shadohead/launchlab/THIRD_PARTY_NOTICES.md

# Attribution

- BP Gear Port Connector: Migbello, [Thingiverse 6856080](https://www.thingiverse.com/thing:6856080), Creative Commons Attribution Share Alike; version unspecified in the supplied notice. LaunchLab modifications include the adapter, latch bridge, optical cradle, pressure plate and M5 mount. Preserved notices accompany the hardware. No endorsement is implied.
- [VQF](https://github.com/dlaidig/vqf), Daniel Laidig and Thomas Seel: MIT; vendored commit `86ba56bdd3158b9b05f9f9fe5596866ba326438c` with copyright headers and license intact.
- Bosch BMI270 Sensor API: **BSD-3-Clause**, vendored via SparkFun_BMI270_Arduino_Library commit `21ea234de321da07c552f7a43cb36f7df4f73a27`. Copyright, conditions and disclaimer are retained in `firmware/LaunchLabMini/src/bmi270/LICENSE` and each frozen source release.
- [M5Unified](https://github.com/m5stack/M5Unified) 0.2.23 and [M5GFX](https://github.com/m5stack/M5GFX) 0.2.30: retain upstream MIT licenses when downloaded by the build.
- [Arduino ESP32](https://github.com/espressif/arduino-esp32) 3.3.0: upstream LGPL-2.1 and component licenses apply. Toolchain sources are obtained by the build script; compiled firmware includes these components.
- [esptool-js](https://github.com/espressif/esptool-js) 0.7.0: Apache-2.0; dependency of the retired GitHub Pages updater.
- [spark-md5](https://github.com/satazor/js-spark-md5) 3.0.2: MIT; dependency of the retired GitHub Pages updater.

The retired GitHub Pages interface used DM Sans and Space Grotesk from Google Fonts under the SIL Open Font License. The compatibility page now contains only an HTML redirect and static artifacts. The maintained updater and its dependencies live in [Beywatch](https://github.com/shadohead/beywatch).

## Bosch BMI270 binary distribution notice

Copyright (c) 2023 Bosch Sensortec GmbH. All rights reserved.

BSD-3-Clause

Redistribution and use in source and binary forms, with or without
modification, are permitted provided that the following conditions are met:

1. Redistributions of source code must retain the above copyright
    notice, this list of conditions and the following disclaimer.

2. Redistributions in binary form must reproduce the above copyright
    notice, this list of conditions and the following disclaimer in the
    documentation and/or other materials provided with the distribution.

3. Neither the name of the copyright holder nor the names of its
    contributors may be used to endorse or promote products derived from
    this software without specific prior written permission.

THIS SOFTWARE IS PROVIDED BY THE COPYRIGHT HOLDERS AND CONTRIBUTORS
"AS IS" AND ANY EXPRESS OR IMPLIED WARRANTIES, INCLUDING, BUT NOT
LIMITED TO, THE IMPLIED WARRANTIES OF MERCHANTABILITY AND FITNESS
FOR A PARTICULAR PURPOSE ARE DISCLAIMED. IN NO EVENT SHALL THE
COPYRIGHT HOLDER OR CONTRIBUTORS BE LIABLE FOR ANY DIRECT, INDIRECT,
INCIDENTAL, SPECIAL, EXEMPLARY, OR CONSEQUENTIAL DAMAGES
(INCLUDING, BUT NOT LIMITED TO, PROCUREMENT OF SUBSTITUTE GOODS OR
SERVICES; LOSS OF USE, DATA, OR PROFITS; OR BUSINESS INTERRUPTION)
HOWEVER CAUSED AND ON ANY THEORY OF LIABILITY, WHETHER IN CONTRACT,
STRICT LIABILITY, OR TORT (INCLUDING NEGLIGENCE OR OTHERWISE) ARISING
IN ANY WAY OUT OF THE USE OF THIS SOFTWARE, EVEN IF ADVISED OF THE
POSSIBILITY OF SUCH DAMAGE.
