shadohead/launchlab/site/public/hardware/downloads/top-dock-v098.3mf

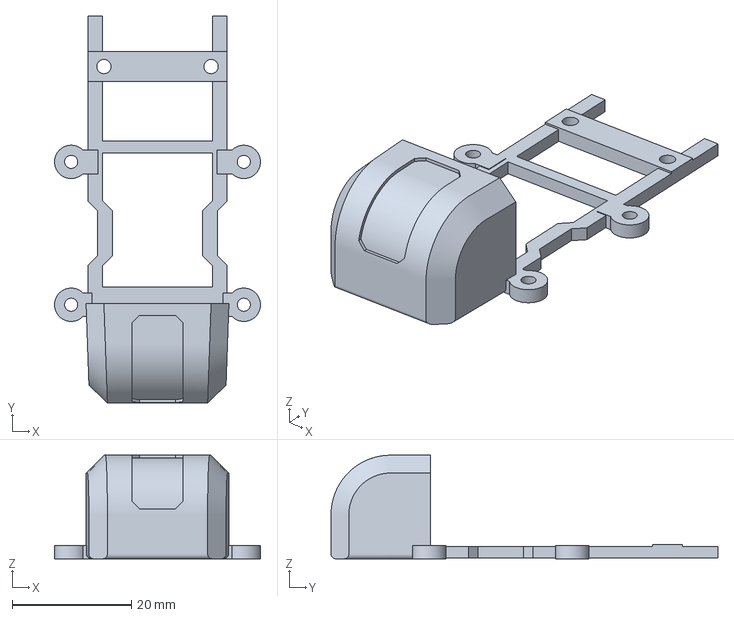
[picture p1: CAD file, 2026-10-12]
site/public/hardware/downloads/top-dock-v098.3mf
34.6 x 65.0 x 17.4 mm
