shadohead/launchlab/site/public/hardware/downloads/compact-base-v102.3mf

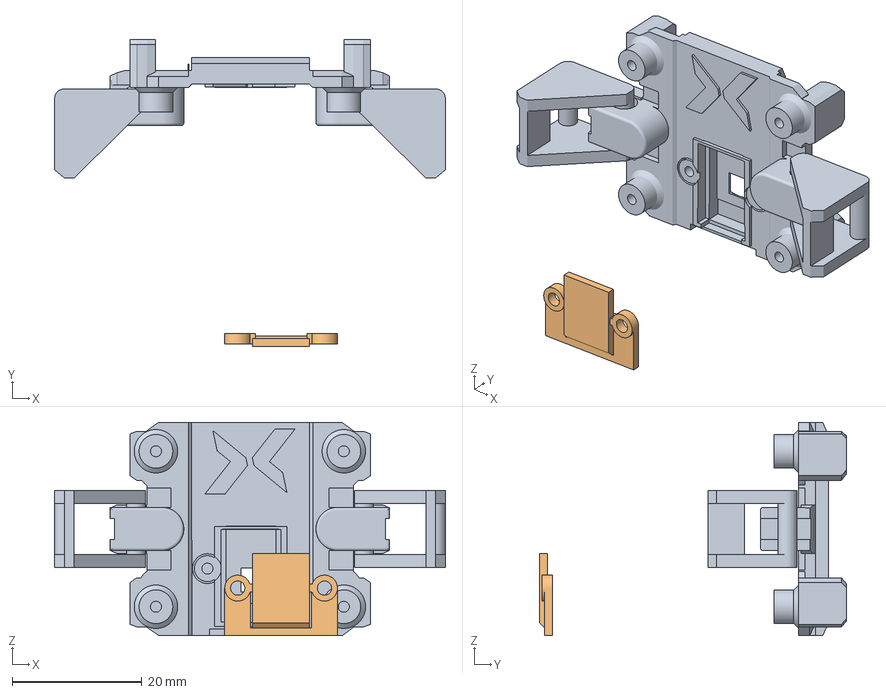
[picture p2: CAD file, 2026-10-12]
site/public/hardware/downloads/compact-base-v102.3mf
60.4 x 47.4 x 33.0 mm
01_QRE_OPEN_PRINT_IN_PLACE
03_QRE_pressure_bar
