shadohead/launchlab/site/public/hardware/downloads/m5-carrier-v097.3mf

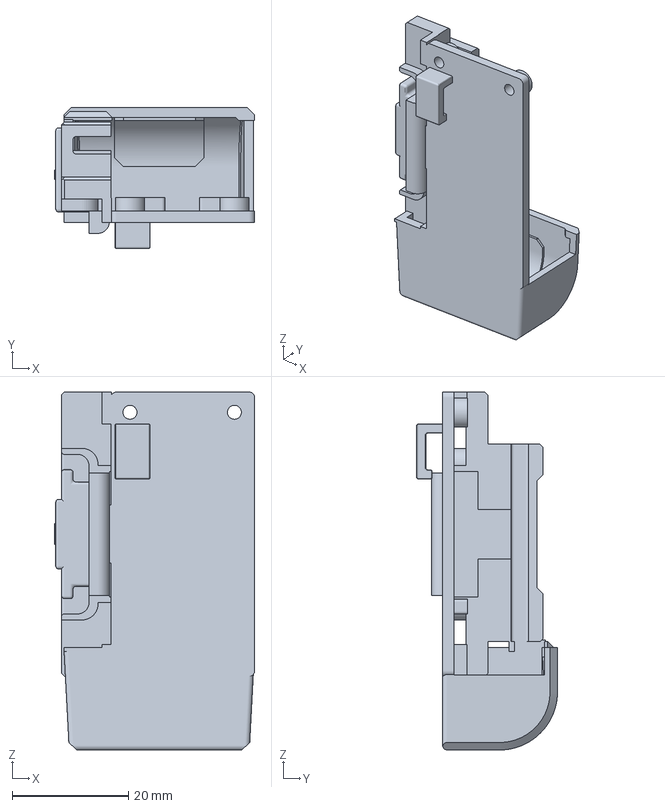
[picture p3: CAD file, 2026-10-12]
site/public/hardware/downloads/m5-carrier-v097.3mf
34.5 x 24.3 x 61.7 mm
