shadohead/launchlab/site/public/hardware/downloads/standard-hinge-test-v069.3mf

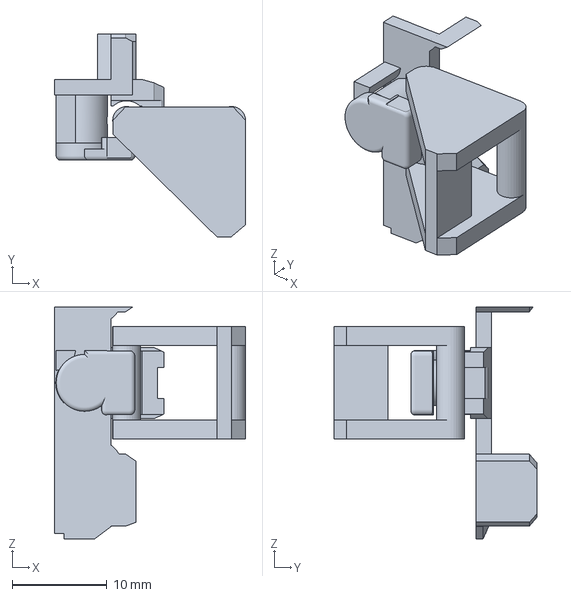
[picture p4: CAD file, 2026-10-12]
site/public/hardware/downloads/standard-hinge-test-v069.3mf
20.2 x 21.4 x 24.5 mm
