shadohead/launchlab/site/public/hardware/downloads/top-mount-v2-petg.3mf

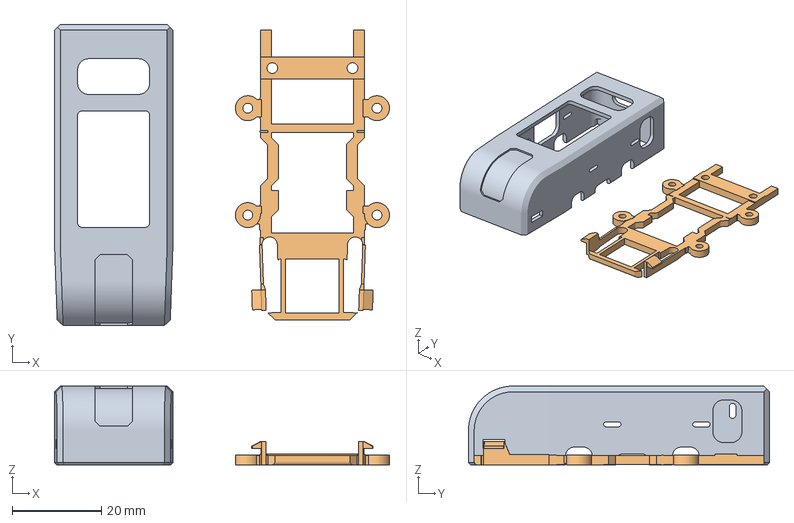
[picture p5: CAD file, 2026-10-12]
site/public/hardware/downloads/top-mount-v2-petg.3mf
75.2 x 67.6 x 17.7 mm
M5 Top_Mount v2 drop-over cover PETG
M5 Top_Mount v2 dock PETG
