shadohead/launchlab/site/public/hardware/downloads/standard-sensor-v102.3mf

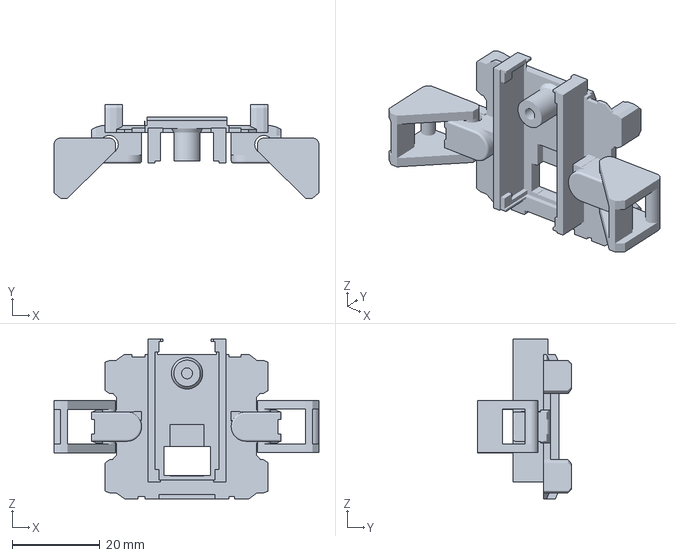
[picture p6: CAD file, 2026-10-12]
site/public/hardware/downloads/standard-sensor-v102.3mf
60.4 x 21.4 x 36.4 mm
