shadohead/launchlab/site/public/hardware/downloads/sidecar-v2-pla.3mf

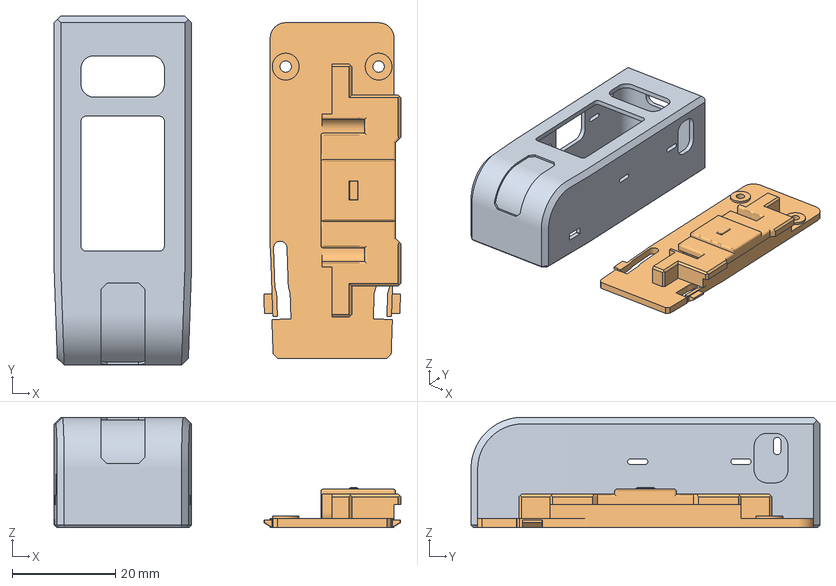
[picture p7: CAD file, 2026-10-12]
site/public/hardware/downloads/sidecar-v2-pla.3mf
67.1 x 67.6 x 21.4 mm
M5 Sidecar v2 drop-over cover PLA
M5 Sidecar v2 snap-clip base PLA
