shadohead/launchlab/site/public/hardware/downloads/compact-base-v098.3mf

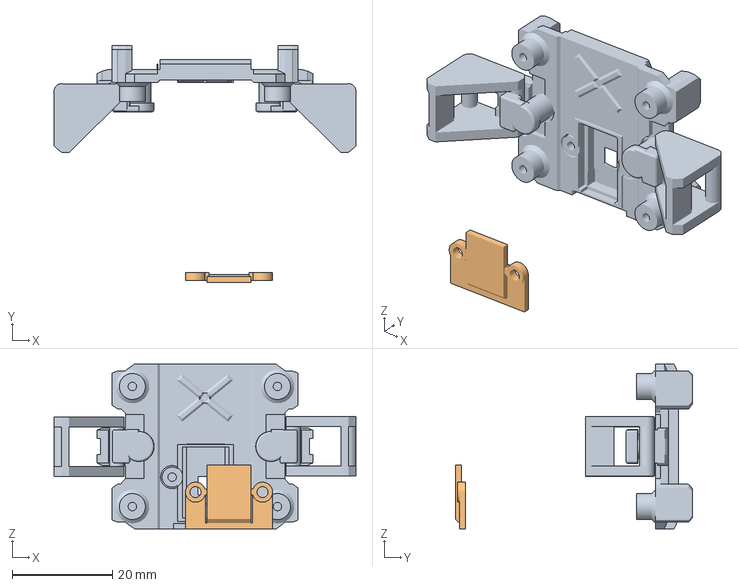
[picture p8: CAD file, 2026-10-12, an earlier design]
site/public/hardware/downloads/compact-base-v098.3mf
60.4 x 47.4 x 33.0 mm
01_QRE_OPEN_PRINT_IN_PLACE
03_QRE_pressure_bar
