shadohead/launchlab/(list of files, cad)

Other CAD files:
site/public/hardware/downloads/sidecar-v2-petg.3mf
site/public/hardware/downloads/standard-sensor-v069-prusa.3mf
site/public/hardware/downloads/top-mount-v2-pla.3mf
site/public/hardware/downloads/m5-carrier-v097-prusa.3mf
site/public/hardware/downloads/standard-sensor-v069.3mf
