shadohead/launchlab/firmware/releases/0.20.9-sticks3-songs-pm/source/LaunchLabMini.ino

#include <M5Unified.h>
#include <Preferences.h>
#include <memory>
#include "esp_mac.h"
#include "acquisition.h"
#include "level_indicator.h"
#include "practice_store.h"
#include "history_log.h"
#include "spiffs_flash.h"
#include "loaded_effects.h"
#include "fx_transfer.h"
#if LAUNCHLAB_HIL
// Test builds: the NVS write faults (hil.h) also slow, fail or arm the history log writes.
namespace Hil{inline bool nvsWrite(const char *key,size_t bytes);}
#endif
#include "practice_ui.h"
#include "power_status.h"
#include "sensor_idle.h"
#include "cpu_power.h"
#include "power_savers.h"
#include "frame_rows.h"
#ifndef LAUNCHLAB_MOTION_ADC_GATE
#define LAUNCHLAB_MOTION_ADC_GATE 0
#endif
#include "usb_awake.h"
#include <HWCDC.h>
#include "usb_tx.h"
#include "usb_command_guard.h"
#include "power_diagnostics.h"
#ifndef LAUNCHLAB_POWER_LAB
#define LAUNCHLAB_POWER_LAB 0
#endif
#if LAUNCHLAB_POWER_LAB
#include "power_lab.h"
// Battery lab test builds (power_lab_device.h): the open run's profile; the
// shipped behaviour (default knobs) when no run is open.
namespace Lab {inline PowerLab::Knobs knobs;inline bool running=false,displayAsleep=false;inline uint32_t frames=0,rows=0,loops=0;}
#endif
#include <sys/time.h>
#include <esp32-hal-cpu.h>
#include <esp_heap_caps.h>
#include <esp_memory_utils.h>
#include <nvs.h>
#include "shake_wake.h"
#include "wake_ui_state.h"
#include "rpm_estimator_setting.h"
#include "brightness.h"
#include "display_flip_setting.h"
#include "ble_link.h"
#include "ble_motion.h"
#include "bluetooth_setting.h"
#include "shake_wake_setting.h"
#include "battery_icon_setting.h"
#include "display_orientation.h"
#include "sensor_profile_setting.h"
#include "start_mark_reference.h"
#include "mount_orientation_setting.h"
#include "dark_display.h"
#include "controls_ui.h"
#include "motion_acquisition.h"
#include "i2c_bus_recovery.h"
#include "motion_store.h"
#include "motion_ui.h"
#include "launch_feedback.h"
#include "appearance_store.h"
#include "milestones.h"
#include "milestone_store.h"
#include "effect_set.h"
#include "best_effect_ui.h"
#include "screens_ui.h"
#include "theme_store.h"
#include "best_effect_speaker.h"
#include "device_backup.h"
#include "nvs_budget.h"
#include "radio_calibration.h"
#include "device_wipe_nvs.h"
#include "wipe_confirmation.h"
#include "settings_save.h"

// loop() runs on an 8 KB task. GCC inlines static helpers called once, and the
// frames of inlined bodies add up: 0.11.0's loop frame reached 6.9 KB and
// overflowed on the first status print. Keep heavy or rarely used helpers as
// real calls so each one uses stack only while it runs.
#define LOOP_HELPER __attribute__((noinline))
#if LAUNCHLAB_HIL
// Test-only hardware-in-the-loop build; never a release. See tools/hil.
static constexpr char VERSION[] = "0.20.9-sticks3-songs-hil-pm";
#elif LAUNCHLAB_CPU_PM
static constexpr char VERSION[] = "0.20.9-sticks3-songs-pm";
#else
static constexpr char VERSION[] = "0.20.9-sticks3-songs";
#endif
static_assert(sizeof(VERSION)<=DeviceBackup::RUNTIME_BYTES,"Runtime must fit the USB backup header");
#ifndef LAUNCHLAB_CPU_MHZ
#define LAUNCHLAB_CPU_MHZ 80
#endif
static_assert(LAUNCHLAB_CPU_MHZ==80 || LAUNCHLAB_CPU_MHZ==160 || LAUNCHLAB_CPU_MHZ==240,
  "CPU policy must retain the 80 MHz peripheral clock");
static_assert(!LAUNCHLAB_CPU_PM || LAUNCHLAB_CPU_MHZ==80,"Experimental DFS uses a maximum of 80 MHz");
static constexpr uint32_t ANALOG_SAMPLE_HZ = StickS3Acquisition::SAMPLE_HZ;
#include "raw_transfer.h"
#include "mic_listener.h"
#include "mic_view_ui.h"
static StickS3Acquisition acquisition;
static Preferences prefs;
static StickS3Level level;
static M5Canvas screen(&M5.Display);
// What the panel shows, for pushing only the rows that changed (frame_rows.h).
static FrameRows frameRows;static uint8_t frameRotation=0xff;
static PracticeHistory practice;
// USB `t`'s synthetic history (2.6 KB), in PSRAM like micListener: only the
// loop reads it (the History page, its B button and `t`), never a save, the
// IMU or acquisition tasks, an interrupt or a flash write.
static PracticeHistory &demoPractice=*new(heap_caps_aligned_alloc(alignof(PracticeHistory),sizeof(PracticeHistory),MALLOC_CAP_SPIRAM|MALLOC_CAP_8BIT)) PracticeHistory;
static PracticeStore practiceStore;
static Appearance::Config appearance;
static Appearance::Bests personalBests;
static AppearanceStore<Appearance::Config> appearanceStore;
static AppearanceStore<Appearance::Bests> bestStore;
// Automatic saves (history, bests, the power log) go to the history log in
// the spiffs partition (history_log.h): program-only writes the ADC rides,
// no checkpoint and no NVS while the device is in use. NVS keeps 0.15-0.17's
// records as the mirror written at sleep, power-off and restore. Without the
// log (another layout found there), they go to NVS in a checkpoint as before.
static SpiffsFlash spiffsFlash;static HistoryLog::Store<SpiffsFlash> historyLog;
// Loaded effects (loaded_effects.h, docs/FIRMWARE_LOADABLE_EFFECTS.md): the
// store in the same partition and the engine that plays them, allocated at
// boot after the ADC has its DMA memory (internal heap), the playing file in
// PSRAM. Null when either allocation failed: loaded IDs then play their fallbacks.
static LoadedEffects<SpiffsFlash> *loadedEffects=nullptr;
// USB `X`: the request's base64 text and its bytes, in PSRAM, allocated at the first `X`.
static FxTransfer::Receiver effectRx;static char *effectRxText=nullptr;static uint8_t *effectRxBytes=nullptr;
static int64_t effectGuardStart=0;
static uint32_t loggedHistory=0,loggedBests=0;
static uint32_t powerMirror=0;  // checksum of the power log NVS holds
// The user's custom themes (theme IDs THEMES..), beside the appearance record.
static Themes::Library themeLibrary;
static ThemeStore themeStore;
// The Celebrate mode and the RPM milestone table, one record beside them. A
// damaged record shows the defaults and is replaced by the next change.
static Milestones::Config milestones;
static MilestoneStore milestoneStore;
// Each row's next effect, picked from its pool ahead of the pull that plays
// it, so its sound is rendered in time; picked again after it plays (never
// the same twice in a row when the pool has more) and when the table changes.
static Appearance::Effect milestoneNext[Milestones::MAX_ROWS];
static Milestones::Config milestonePicked;static bool milestonePicksReady=false;
// The effect set: the effects Best effect offers and Random draws from, a
// record beside them. A damaged record offers the default set and is
// replaced by the next change.
static EffectSet::Config effectSet;
static AppearanceStore<EffectSet::Config> effectSetStore;
static Appearance::Celebration bestEffect;
// The Best effect editor previews the draft around its value card.
static Appearance::Celebration editorEffect;
// Random's next pick, chosen ahead of the next best so its sound can render.
static Appearance::Effect upcomingEffect=Appearance::Effect::Off;
static BestEffectUI::Renderer bestEffectRenderer;
static bool effectWasMoving=false;
static PracticeUI::View historyView=PracticeUI::View::Recent;
static bool historyPage=false,demo=false,saveError=false;
static bool tournamentMode=false;
enum class TournamentView:uint8_t { RecordingOnly, Rpm };
static TournamentView tournamentView=TournamentView::RecordingOnly;
static Controls::State controls;
static Controls::Gesture gestureA,gestureB;
static WipeConfirmation wipeConfirmation;
static bool wipeFailed=false,wipeBlocked=false,wipeComplete=false;
static bool wipeCheckpointHeld=false,wipeBootRecovery=false,wipeRestartRequested=false;
static bool restorePreview=false;
static uint32_t tournamentHintUntil=0;

static unsigned historyOffset=0;
static uint32_t lastSaveTry=0,saveCount=0,saveErrors=0,maxSaveUs=0,newSessionAt=0;
static constexpr uint32_t HISTORY_COALESCE_MS=10000;
static constexpr uint32_t CELEBRATION_HOLD_MS=1000;
static constexpr uint32_t HISTORY_SAVE_RETRY_MS=5000;
static uint32_t lastAcceptedAt=0,historyPendingSince=0;
static bool screenReady=false;
static bool diagnostics=false,extPower=false,stress=false,dirty=true;
static uint32_t lastDraw=0,lastStatus=0,lastRevision=0,maxDrawUs=0,maxEffectUs=0,uiStalls=0;
#if LAUNCHLAB_HIL
// HIL only: each recap effect pass since the last E preview (elapsed ms, us),
// listed by `!effectframes`, to see where in an effect its time goes.
static struct {uint16_t elapsed[128],us[128];unsigned count=0;} effectFrames;
// The loaded-effects spike (hil_fx.h): draws a previewing file instead.
static bool hilFxDraw(uint16_t *pixels,int width,int height,uint32_t elapsed,uint16_t accent,uint16_t background);
#ifdef BEST_EFFECT_PROFILE
// A profiling debug build only: each pass's cycles per renderer stage, for
// `!effectstages`.
static struct {uint16_t elapsed[64];uint32_t us[64],cycles[64][BestEffectUI::Renderer::STAGES];unsigned count=0;} effectStages;
#endif
#endif
static uint32_t lastImuPoll=0,maxImuPollUs=0;
static StickS3Level::Reading drawnLevel;
static InactivityTimer inactivity;static OpticalSleepGuard opticalGuard;static HeldButtonUse heldButtons;
static uint64_t lastActivityMotionUs=0;
// USB letters a stray byte stream sent outside a standalone command.
static UsbCommandGuard usbCommands;
// Automatic checkpoints prefer a launcher the IMU shows set down.
static HistoryCheckpoint::Stillness imuStill;
static SensorIdle sensorIdle;
static UsbHostAwake usbAwake;
static bool usbAutoOffInhibited=false;
static StickS3ShakeWake shakeWake;
// A side-key click is latched by the G13 edge ISR and acted on by the loop.
static volatile bool powerKeyIrq=false;
static bool powerKeyRequested=false;
static uint32_t powerKeyRequestedAt=0,lastPowerKeyRead=0;
static constexpr uint32_t POWER_KEY_WAIT_MS=10000;
static bool settingsSaveError=false;
static SettingsSave settingsSave;
// A stopped, non-resting ADC owner outlasting this is a lost checkpoint reply.
static constexpr uint32_t ORPHAN_CHECKPOINT_MS=1000;
static bool orphanSeen=false;static uint32_t orphanSince=0;
static uint8_t brightnessPercent=Brightness::DEFAULT_PERCENT;
static bool displayFlipped=false;
// Shake to wake (0.20.2, shake_wake_setting.h): whether an inactivity sleep arms the IMU wake.
static bool shakeToWake=ShakeWakeSetting::DEFAULT_ON;
// Battery icon (0.20.8, battery_icon_setting.h): the charge in the screens' top right corner.
static bool batteryIcon=BatteryIconSetting::DEFAULT_ON;
static ControlsUI::CornerBattery drawnCornerBattery;  // as last drawn
// Off until chosen under Settings; the stack then starts without a restart.
static bool bluetoothOn=BluetoothSetting::DEFAULT_ON;
// As read at boot: the layout and the stack follow this until a restart.
static bool bluetoothAtBoot=BluetoothSetting::DEFAULT_ON;
static RpmEstimator::Mode rpmEstimator=RpmEstimator::DEFAULT_MODE;
static StickS3SensorProfile::Mode sensorProfile=StickS3SensorProfile::DEFAULT_MODE;
static MountOrientation::Mode mountMode=MountOrientation::Mode::Top;
// The frame level data and the IMU owner actually use. A new mount choice is
// switched to inside its save checkpoint: switching clears the IMU ring, which
// must never happen during a pull or its capture.
static MountOrientation::Mode liveMount=MountOrientation::Mode::Top;
static StickS3Battery battery;
static DarkDisplay darkDisplay;
static uint32_t lastBatteryPoll=0,maxBatteryPollUs=0,lastShutdownTry=0;
static bool batteryPolled=false;
static bool powerConfigValid=false;
static uint8_t powerConfig=0;
static Preferences powerPrefs;
static PowerDiagnostics::Image powerLog;
static bool powerLogReady=false,powerLogDirty=false;
static uint32_t powerLogTick=0,lastPowerSample=0,lastPowerSaveTry=0;
struct SleepReceipt {uint32_t magic;int64_t atUs;};
RTC_DATA_ATTR static SleepReceipt sleepReceipt={};
RTC_DATA_ATTR static UsbStandby usbStandby={};
static bool finishStandby=false;
// What the timer re-check of a USB-retained standby read before the boot:
// PM1's power source (0x04) and system IRQ mask (0x44, bit 1 = 5VIN removal).
static struct {bool ran=false,read=false;uint8_t source=0,mask=0xff;} standbyRecheck;
#if LAUNCHLAB_HIL
static char standbyWakeText[224]="none";  // USB_STANDBY_WAKE's fields, for HIL !standbywake (setup writes 224)
#endif
#if LAUNCHLAB_HIL
// !usbstandby <s>: the next USB-retained standby re-checks after s seconds
// and then boots rather than sleeping again, so the rig gets the unit back.
RTC_DATA_ATTR static uint32_t hilStandbyRecheckS=0;
#endif
static uint8_t pm1WakeFlags=0;
static bool pm1WakeValid=false;
static StickS3MotionAcquisition imuAcquisition;
static BestEffectSpeaker soundPlayer(imuAcquisition);
// In PSRAM, made before setup() (the IDF adds PSRAM to the heap before the
// constructors run): the internal heap keeps every byte for pulls and songs.
static MicListener &micListener=*new(heap_caps_aligned_alloc(alignof(MicListener),sizeof(MicListener),MALLOC_CAP_SPIRAM|MALLOC_CAP_8BIT)) MicListener(imuAcquisition);
// A frame costs 22-43 ms at 80 MHz (the 0.20.5 gate's recaps) and the tracker
// runs below the UI, so the Mic RPM page redraws at 5 Hz at most.
static constexpr uint32_t MIC_PAGE_FRAME_MS=200;
static uint32_t micPageChecked=0;static bool micPageWarm=false,micPageFresh=false;
// Which sound is playing: a celebration stops when its recap goes, a Settings
// preview when its editor closes. A requested sound that is not rendered yet
// waits for the idle slices rather than stalling the UI loop to render it.
static bool celebrationSound=false,soundPreview=false;
static struct {bool active=false,celebration=false;Appearance::Effect effect=Appearance::Effect::Off;Appearance::Sound level=Appearance::Sound::Off;} soundRequest;
// From reading an effect frame's elapsed time to that frame on the glass
// (effect draw and push), measured each frame: SoundSync lines sound up with it.
static int64_t effectReadUs=0;static uint32_t presentLagUs=15000;
// The last sound start: how far its effect's clock moved, or the samples it
// skipped to join late (SOUND_SYNC).
static int32_t soundShiftMs=0;static uint32_t soundSkipped=0;
// A celebration sound that cannot start within this long after its effect is dropped.
static constexpr uint32_t SOUND_LATE_MS=300;
// A song is heard from its first block, queued once its pre-roll is rendered
// (music_stream.h, 30-95 ms after it starts): its effect holds its first
// frame until then, this long at most, and tickSound() lines it up.
static Appearance::Celebration *songCue=nullptr;static uint32_t songCueFrom=0;
static constexpr uint32_t SONG_HOLD_MS=500;
static void requestSound(Appearance::Effect effect,Appearance::Sound level,bool celebration);static void startSound(bool late);
static const char *milestoneStoreName();static const char *effectSetFields();
static Appearance::Effect celebrationEffect();static Appearance::Effect soundTarget();
static const Appearance::Effect *milestonePicks();static void nextMilestonePick(uint16_t rpm,Appearance::Effect played);
static constexpr size_t USB_TX_BUFFER_BYTES=8192;
// HWCDC drops bytes once its RX queue is full, and a tool's request line
// arrives in one burst. Every build uses this size: the HIL build alone once
// had a large queue, which hid that production's 256-byte one lost the end of
// every v3 milestone request (312 characters), so no save reached 0.18.0.
static constexpr size_t USB_RX_BUFFER_BYTES=8192;
static constexpr uint32_t MOTION_INIT_RETRY_MS=5000,MOTION_DATA_TIMEOUT_MS=250;
// The 1024-sample ring (10 s at 100 Hz) still holds a pull for this long.
static constexpr uint64_t MOTION_CAPTURE_RETRY_US=3000000;
static uint32_t motionCaptureRetries=0,motionRestoreFailures=0;
static bool motionRestoreNeeded=false;
static uint32_t motionInitAttempts=0,lastMotionInit=0;
static bool motionInitPaired=false,motionInitSuccess=false;
static MotionStore motionStore;
// A restore's base64 text, in PSRAM (allocated at the first R): a backup
// with loaded effects can carry up to 32 of them. Decoded in place.
static DeviceBackup::BufferReceiver restoreRx;static char *restoreText=nullptr;
// One framed custom theme request (USB `T`).
static DeviceBackup::LineReceiver<(Themes::Request::BYTES+2)/3*4> themeRx;
// One framed milestone request (USB `U`).
static DeviceBackup::LineReceiver<(Milestones::Request::BYTES+2)/3*4> milestoneRx;
static LaunchMotion::Trace latestMotion,referenceMotion,demoMotion;
// The latest pull's RPM turn by turn (the recap's graph); empty after a restart.
static AnalogTachometer::Curve latestCurve;
static bool motionPending=false,referenceError=false,motionDemo=false;
static uint64_t motionStart=0,motionEnd=0,lastLevelSampleUs=0;
static uint32_t motionDrops=0;
static I2cBusRecovery::Result i2cRecovery=I2cBusRecovery::Result::Idle;static unsigned i2cRecoveryPulses=0;
static bool i2cSdaWas=true,i2cSclWas=true;
static LaunchFeedback launchFeedback;
static AnalogTachometer::Phase lastPhase=AnalogTachometer::Phase::Paused;
static bool lastFault=false;
using Action=StickS3Acquisition::Action;
using Snapshot=StickS3Acquisition::Snapshot;
enum class ShutdownFlush:uint8_t {Busy,NewPull,SaveFailed,Ready};

static bool motionSensorPaired() {
  // isEnabled only establishes driver detection. Require an actual new paired
  // read before starting the fusion owner; cached data and rest are not tests.
  M5.Imu.setCalibration(0,0,0);
  const uint32_t started=millis();
  do {
    const unsigned fresh=M5.Imu.update();
    const unsigned both=m5::IMU_Class::sensor_mask_accel|m5::IMU_Class::sensor_mask_gyro;
    if((fresh&both)==both) {
      const auto data=M5.Imu.getImuData();
      if(std::isfinite(data.accel.x) && std::isfinite(data.accel.y) && std::isfinite(data.accel.z) &&
         std::isfinite(data.gyro.x) && std::isfinite(data.gyro.y) && std::isfinite(data.gyro.z))return true;
    }
    delay(5);
  } while(uint32_t(millis()-started)<MOTION_DATA_TIMEOUT_MS);
  return false;
}

static bool startMotion() {
  if(imuAcquisition.running())return true;
  // No IMU owner exists here. Main-thread power/level calls are serialized;
  // only the missing IMU is reinitialized, not M5 or optical acquisition.
  ++motionInitAttempts;lastMotionInit=millis();
  // Every M5 begin resets the BMI270 range and FIFO; both must follow detection.
  motionInitPaired=M5.Imu.isEnabled() && configureMotionSensor() && motionSensorPaired();
  if(!motionInitPaired) {
    const bool detected=M5.Imu.begin(&M5.In_I2C,m5::board_t::board_M5StickS3);
    motionInitPaired=detected && configureMotionSensor() && motionSensorPaired();
  }
  // Nothing is captured before the owner starts, so it can take the chosen mount.
  const bool mounted=motionInitPaired && imuAcquisition.setMount(mountMode);
  if(mounted)liveMount=mountMode;
  motionInitSuccess=mounted && imuAcquisition.begin();
  Serial.printf("IMU_STARTUP attempt=%lu enabled=%d type=%d paired=%d task=%d elapsed_ms=%lu\n",
    (unsigned long)motionInitAttempts,M5.Imu.isEnabled(),int(M5.Imu.getType()),motionInitPaired,
    imuAcquisition.running(),(unsigned long)(millis()-lastMotionInit));
  return motionInitSuccess;
}

// Every flash write runs inside an ADC checkpoint (DMA cannot survive the
// cache stall either). The same boundary keeps IMU transfers out of the stall.
// If no quiet window can be established the checkpoint is vetoed; every
// caller already treats a refused checkpoint as busy and retries later.
static bool quietImuForFlash(Action action,bool done,bool ok) {
  const bool writes=action==Action::IdleCheckpointBegin || action==Action::ShutdownBegin || action==Action::ShutdownForce ||
    action==Action::HistoryIdleCheckpointBegin || action==Action::CheckpointBegin;
  if(writes && !done)return imuAcquisition.quiet();
  if((writes && !ok) || action==Action::CheckpointEnd)imuAcquisition.endQuiet();
  return true;
}

// A cancelled standby re-applies M5's measurement configuration and the FIFO.
// If that fails the IMU task keeps running on an unconfigured sensor, so the
// task existing is not proof of tilt data: retry the restore until it works.
static void noteMotionRestoreFailure(){motionRestoreNeeded=true;++motionRestoreFailures;lastMotionInit=millis();}
LOOP_HELPER static void retryMotion(uint32_t now,const Snapshot &s) {
  if(motionPending || uint32_t(now-lastMotionInit)<MOTION_INIT_RETRY_MS ||
     (s.phase!=AnalogTachometer::Phase::Ready && s.phase!=AnalogTachometer::Phase::Paused))return;
  if(!imuAcquisition.running()){startMotion();dirty=true;return;}
  if(!motionRestoreNeeded || !imuAcquisition.lock())return;
  lastMotionInit=now;
  const bool restored=shakeWake.restore();imuAcquisition.unlock();
  if(restored)motionRestoreNeeded=false;else ++motionRestoreFailures;
  Serial.printf("IMU_RESTORE_RETRY ok=%d failures=%lu\n",restored,(unsigned long)motionRestoreFailures);dirty=true;
}

static uint8_t backlightValue(){return (unsigned(brightnessPercent)*255+50)/100;}
// During a pull the preview can be deferred. Sensor coordinates must follow
// the LCD orientation that was actually applied, rather than an unseen draft.
static bool visibleDisplayFlipped(){return DisplayOrientation::flipForRotation(M5.Display.getRotation());}
static Appearance::Theme visibleTheme(){return controls.page==Controls::Page::Edit && controls.setting==5?Appearance::Theme(controls.draft):appearance.theme;}
// The colors on screen: the Theme editor's draft while it is open. A custom
// theme that is missing or invalid shows the default.
static Palette::Colors ui(){return themeLibrary.colors(visibleTheme());}
static void cancelSettingEdit();
static void beginWipe();
static void cancelWipe();
static bool saveWakeNavigation(){return prefs.putUInt("wake_nav",Controls::encodeWake(controls,uint8_t(tournamentView)))==sizeof(uint32_t);}
static void syncNavigation() {
  tournamentMode=controls.page==Controls::Page::Tournament;
  historyPage=controls.page!=Controls::Page::Main && !tournamentMode;
  if(controls.page==Controls::Page::History)historyView=PracticeUI::View(controls.history);
  else if(controls.page==Controls::Page::Battery)historyView=PracticeUI::View::Battery;
  else if(controls.page==Controls::Page::Settings || controls.page==Controls::Page::Edit || controls.page==Controls::Page::Wipe ||
          controls.page==Controls::Page::About)historyView=PracticeUI::View::Settings;
  dirty=true;
}
static int64_t wallUs(){timeval t;gettimeofday(&t,nullptr);return int64_t(t.tv_sec)*1000000+t.tv_usec;}
static uint8_t powerFlags(){return (battery.charging?PowerDiagnostics::Charging:0)
  | (battery.chargeKnown?PowerDiagnostics::ChargeKnown:0) | (powerConfigValid && (powerConfig&0x10)?PowerDiagnostics::Led:0)
  | (extPower?PowerDiagnostics::Boost:0) | (tournamentMode?PowerDiagnostics::Tournament:0) | PowerDiagnostics::SensorRail;}
static void powerRecord(uint8_t event,uint8_t wake=0){PowerDiagnostics::append(powerLog,event,battery.voltageOk?battery.millivolts:0,
  powerFlags(),M5.Display.getBrightness(),ESP.getCpuFreqMHz(),wake);powerLogDirty=true;}
static bool savePowerLog(){
  // Bound retries after an NVS failure; repeated checkpoints keep the detector
  // in Settling and prevent subsequent pulls from being measured.
  lastPowerSaveTry=millis();
  if(!powerLogReady)return false;powerLog.checksum=PowerDiagnostics::hash(powerLog);
  const bool ok=powerPrefs.putBytes("log",&powerLog,sizeof(powerLog))==sizeof(powerLog);
  if(ok){powerLogDirty=false;powerMirror=powerLog.checksum;}return ok;
}
LOOP_HELPER static void exportPowerLog(){
  Serial.printf("POWER_LOG schema=1 boots=%lu power_button_wakes=%lu shake_wakes=%lu other_wakes=%lu sleeps=%lu awake_s=%llu known_sleep_s=%llu unknown_sleep_intervals=%lu charging_awake_s=%llu led_awake_s=%llu boost_awake_s=%llu display_awake_s=%llu records=%lu storage_ready=%d unsaved=%d current_ma=unavailable\n",
    (unsigned long)powerLog.boots,(unsigned long)powerLog.powerButtonWakes,(unsigned long)powerLog.shakeWakes,
    (unsigned long)powerLog.otherWakes,(unsigned long)powerLog.sleeps,powerLog.awakeMs/1000,powerLog.sleepMs/1000,(unsigned long)powerLog.unknownSleepIntervals,
    powerLog.chargingMs/1000,powerLog.ledMs/1000,powerLog.boostMs/1000,powerLog.displayMs/1000,
    (unsigned long)powerLog.count,powerLogReady,powerLogDirty);
  for(unsigned i=0;i<powerLog.count;++i){const auto &r=powerLog.records[(powerLog.next+PowerDiagnostics::CAPACITY-powerLog.count+i)%PowerDiagnostics::CAPACITY];
    Serial.printf("POWER_RECORD tracked_s=%llu boot=%lu event=%u battery_mv=%u flags=0x%02x backlight=%u cpu_mhz=%u wake=%u\n",
      r.elapsedSeconds,(unsigned long)r.boot,r.event,r.batteryMv,r.flags,r.brightness,r.cpuMhz,r.wake);}
}
LOOP_HELPER static void tickPowerLog(uint32_t now,const Snapshot &s){
  PowerDiagnostics::account(powerLog,now-powerLogTick,powerFlags(),M5.Display.getBrightness());powerLogTick=now;
  if(now-lastPowerSample>=60000){lastPowerSample=now;powerRecord(PowerDiagnostics::Sample);}
  // A resting owner already holds its checkpoint. Keep optional diagnostics
  // in RAM until motion resumes it or final shutdown flushes the log.
  if(!s.resting && powerLogReady && powerLogDirty && now-lastPowerSaveTry>=300000 &&
    HistoryCheckpoint::practiceIdle(now,lastAcceptedAt,
      HistoryCheckpoint::automaticQuietMs(now,imuStill,now-lastPowerSaveTry-300000,HISTORY_COALESCE_MS),
      motionPending,launchFeedback.protects(now),s.phase)){
    // Record the attempt first: a vetoed checkpoint must not repeat the IMU
    // quiet wait on every UI tick. The dirty log stays pending.
    lastPowerSaveTry=now;
    if(historyLog.isOpen()) {
      // To the log, beside history: no checkpoint (sleep and power-off write NVS).
      powerLog.checksum=PowerDiagnostics::hash(powerLog);
#if LAUNCHLAB_HIL
      if(Hil::nvsWrite("log",sizeof(powerLog)))return;
#endif
      if(historyLog.savePower(powerLog,powerMirror))powerLogDirty=false;else Serial.println("POWER_LOG_NOTICE log_save_failed");
      return;
    }
    if(!acquisition.request(Action::IdleCheckpointBegin,s.launches))return;
    if(!savePowerLog())Serial.println("POWER_LOG_NOTICE checkpoint_failed");acquisition.request(Action::CheckpointEnd);
  }
}


static const char *tournamentViewName() {
  switch(tournamentView) {
    case TournamentView::RecordingOnly:return "recording_only";
    default:return "rpm";
  }
}

// Internal RAM headroom for task stacks, drivers and the UI canvas. The
// minimum is the low-water mark since boot, so it covers backup and restore.
LOOP_HELPER static void heapStatus() {
  constexpr uint32_t INTERNAL=MALLOC_CAP_INTERNAL|MALLOC_CAP_8BIT;
  const void *canvas=screenReady?screen.getBuffer():nullptr;
  // DMA-capable internal RAM: the ADC's continuous driver, the speaker's I2S
  // ring and USB need it; a build once boot-looped when the ADC found none.
  constexpr uint32_t DMA=MALLOC_CAP_DMA|MALLOC_CAP_INTERNAL;
  Serial.printf("HEAP_STATUS internal_free=%u internal_largest=%u internal_min_free=%u dma_free=%u dma_largest=%u dma_min_free=%u psram_free=%u psram_largest=%u canvas=%s canvas_bytes=%u\n",
    unsigned(heap_caps_get_free_size(INTERNAL)),unsigned(heap_caps_get_largest_free_block(INTERNAL)),
    unsigned(heap_caps_get_minimum_free_size(INTERNAL)),unsigned(heap_caps_get_free_size(DMA)),
    unsigned(heap_caps_get_largest_free_block(DMA)),unsigned(heap_caps_get_minimum_free_size(DMA)),
    unsigned(heap_caps_get_free_size(MALLOC_CAP_SPIRAM)),unsigned(heap_caps_get_largest_free_block(MALLOC_CAP_SPIRAM)),
    !canvas?"none":esp_ptr_internal(canvas)?"internal":"psram",unsigned(screenReady?screen.bufferLength():0));
}

// NVS entries; a history save needs one rewrite's worth free, and a negative
// headroom means the next history save would fail for lack of space.
static bool nvsAvailable(unsigned &available){
  nvs_stats_t stats{};if(nvs_get_stats(nullptr,&stats)!=ESP_OK)return false;
  available=unsigned(stats.available_entries);return true;
}

// The start floor while a sound plays (start_mark_reference.h, 0.20.1): this
// unit's recent confirmed pulls' weakest start marks, for its sensor profile.
static StartMarkReference::Reference startMarks;
static bool startMarksDirty=false;
static constexpr const char *START_MARKS_KEY="start_marks";
static void loadStartMarks() {
  StartMarkReference::Image image;const size_t n=prefs.getBytesLength(START_MARKS_KEY);
  if(n!=StartMarkReference::IMAGE_BYTES || prefs.getBytes(START_MARKS_KEY,image,n)!=n ||
     !startMarks.decode(image,unsigned(n)) || startMarks.profile!=uint8_t(sensorProfile))startMarks.clear(uint8_t(sensorProfile));
}
// A confirmed pull's weakest start mark joins the reference of its profile.
static void noteStartMark(const Snapshot &e) {
  if(!e.valid || e.startMark<=0)return;
  if(startMarks.profile!=uint8_t(e.sensorProfile))startMarks.clear(uint8_t(e.sensorProfile));
  startMarks.add(e.startMark);startMarksDirty=true;
}
// Saved with the NVS mirror at sleep and power-off, never while the unit is
// in use. A first save takes NVS room, so it keeps the reserve for optional
// records; an empty reference (a new profile, after a wipe) removes the key.
static void saveStartMarks() {
  if(!startMarksDirty)return;
  if(!startMarks.count) {
    if(!prefs.isKey(START_MARKS_KEY) || prefs.remove(START_MARKS_KEY))startMarksDirty=false;
    return;
  }
  const unsigned own=NvsBudget::blobEntries(StartMarkReference::IMAGE_BYTES);
  const unsigned needed=NvsBudget::optionalNeeded(own,prefs.isKey(START_MARKS_KEY)?0:own,NvsBudget::blobEntries(PracticeHistory::IMAGE_BYTES));
  unsigned available=0;
  if(!nvsAvailable(available) || available<needed){Serial.printf("START_MARKS_NOTICE refused nvs_space available=%u needed=%u\n",available,needed);return;}
  StartMarkReference::Image image;startMarks.encode(image);
  if(prefs.putBytes(START_MARKS_KEY,image,sizeof(image))==sizeof(image))startMarksDirty=false;
  else Serial.println("START_MARKS_ERROR save_failed");
}
// Each loop pass: while any sound plays, a launch starts only on marks half
// as strong as this unit's pulls (at most 400 counts); otherwise as ever.
static void updateStartFloor() {
  static float last=-1;
  // A reference kept for another profile (a restore can change it) does not apply.
  const float minMark=StickS3SensorProfile::minMark(sensorProfile);
  const float floor=!soundPlayer.playing()?0:startMarks.profile==uint8_t(sensorProfile)?startMarks.floor(minMark):minMark;
  if(floor!=last){acquisition.setStartFloor(floor);last=floor;}
}
LOOP_HELPER static void nvsStatus() {
  nvs_stats_t stats{};const esp_err_t error=nvs_get_stats(nullptr,&stats);
  Serial.printf("NVS_STATUS ok=%d used_entries=%u available_entries=%u total_entries=%u namespaces=%u history_save_entries=%u history_headroom=%d\n",
    error==ESP_OK,unsigned(stats.used_entries),unsigned(stats.available_entries),unsigned(stats.total_entries),
    unsigned(stats.namespace_count),NvsBudget::blobEntries(PracticeHistory::IMAGE_BYTES),
    NvsBudget::headroom(unsigned(stats.available_entries),PracticeHistory::IMAGE_BYTES));
}

#if LAUNCHLAB_HIL
static uint32_t hilStatusRuns=0;  // !feedgaps: whether a status print starved a song
#endif
// About 6 KB at USB speed, 40-62 ms: longer than a song's two queued 32 ms
// blocks can cover, so it feeds the song between groups of lines (0.20.7,
// HIL !feedgaps; a Mic RPM session's lines made it underrun).
LOOP_HELPER static void status() {
#if LAUNCHLAB_HIL
  ++hilStatusRuns;
#endif
  BleLink::status();
  RadioCalibration::status();
  Serial.printf("MOTION_RING psram=%d capture_max_us=%lu sizeof=%u\n",imuAcquisition.ringInPsram(),(unsigned long)imuAcquisition.maxCaptureUs,unsigned(sizeof(LaunchMotion::Ring)));
  const Snapshot s=acquisition.snapshot();
  // Least free stack the loop task has had since boot; 0.11.0 overflowed its 8 KB.
  Serial.printf("STACK loop_min_free_bytes=%u\n",unsigned(uxTaskGetStackHighWaterMark(nullptr)));
  Serial.printf("STATUS v=%s board=StickS3 board_id=%d gpio=%u adc_ready=%d suspended=%d ext5v=%d width=%d height=%d rotation=%u samples=%llu delivered_sps=%.0f mean=%.1f min=%lu max=%lu last=%lu overflow_events=%lu read_errors=%lu adc_error=%s\n",
    VERSION,int(M5.getBoard()),s.pin,s.ready,s.suspended,extPower,M5.Display.width(),M5.Display.height(),
    unsigned(M5.Display.getRotation()),
    (unsigned long long)s.samples,s.rate,s.mean,(unsigned long)s.minimum,(unsigned long)s.maximum,
    (unsigned long)s.last,(unsigned long)s.overflows,(unsigned long)s.readErrors,esp_err_to_name(s.error));
  Serial.printf("RPM_STATUS state=%s valid=%d peak_rpm=%.1f live_peak=%.1f launches=%lu edges=%lu weak_rejected=%lu slow_rejected=%lu noise=%.1f amplitude=%.1f rearm_ms=%lu candidate_rpm=%.1f contrast=%.1f hysteresis=%.1f shape_rejected=%lu inconsistent=%lu rearm_extensions=%lu detector_us=%llu recorder_s=%lu min_mark=%.0f edge_fraction=%.2f start_floor=%.0f start_mark=%.0f sound_held=%lu ref_pulls=%u ref_median=%.0f\n",
    s.stateName(),s.valid,s.resultRpm,s.peakRpm,(unsigned long)s.launches,(unsigned long)s.edges,
    (unsigned long)s.weak,(unsigned long)s.slow,s.noise,s.amplitude,(unsigned long)s.rearmMs,
    s.candidateRpm,s.contrast,s.hysteresis,(unsigned long)s.shape,(unsigned long)s.inconsistent,
    (unsigned long)s.rearmExtensions,(unsigned long long)s.detectorUs,
    acquisition.storage()?60ul:0ul,StickS3SensorProfile::minMark(s.sensorProfile),StickS3SensorProfile::EDGE_SWING_FRACTION,
    s.startFloor,s.startMark,(unsigned long)s.soundHeld,unsigned(startMarks.count),startMarks.median());
  soundPlayer.feedSong();
  Serial.printf("SENSOR_PROFILE_STATUS selected=%s min_mark=%.0f saved_setting=%s\n",
    StickS3SensorProfile::name(s.sensorProfile),StickS3SensorProfile::minMark(s.sensorProfile),StickS3SensorProfile::name(sensorProfile));
  Serial.printf("RPM_ESTIMATORS selected=%s units=rpm three_turn_peak_rpm=%.1f single_turn_peak_rpm=%.1f confirmation_turns=3 max_rpm=30000 single_updates=%lu single_rejected=%lu\n",
    RpmEstimator::name(s.estimator),s.sustainedPeakRpm,s.singlePeakRpm,
    (unsigned long)s.singlePeakUpdates,(unsigned long)s.singlePeakRejected);
  Serial.printf("SETTINGS_SAVE_STATUS pending=0x%03x failed=%d saves=%lu errors=%lu refusals=%lu\n",unsigned(settingsSave.pending()),
    settingsSave.failed(),(unsigned long)settingsSave.saves(),(unsigned long)settingsSave.errors(),(unsigned long)settingsSave.refusals());
  soundPlayer.feedSong();
  Serial.printf("TOURNAMENT_STATUS enabled=%d display=%s persistent=wake\n",tournamentMode,tournamentViewName());
  Serial.printf("MILESTONE_STATUS mode=%s rows=%u revision=%lu store=%s\n",Milestones::name(milestones.mode()),milestones.count(),
    (unsigned long)milestones.revision,milestoneStoreName());
  soundPlayer.status(appearance.sound);
  // Not while the speaker is powered (the mic is off then): this pass also
  // feeds a song, with 64 ms queued, and the mic's lines (up to 8 spins'
  // logs) took a status print past it, so songs underran after a Mic RPM
  // session (0.20.7, HIL !feedgaps). Its counters wait for the next status.
  if(!soundPlayer.powered())micListener.status();
  soundPlayer.feedSong();
  Serial.printf("SOUND_SYNC present_lag_us=%lu output_us=%lu clock_shift_ms=%ld skipped_samples=%lu\n",(unsigned long)presentLagUs,
    (unsigned long)soundPlayer.outputUs(),(long)soundShiftMs,(unsigned long)soundSkipped);
  Serial.printf("UI_STATUS page=%u menu=%u history=%u setting=%u draft=%u battery_icon=%d corner_fill=%u corner_bolt=%d recording=%s\n",
    unsigned(controls.page),controls.menu,controls.history,controls.setting,controls.draft,batteryIcon,unsigned(drawnCornerBattery.fill),
    drawnCornerBattery.tone==ControlsUI::CornerBattery::Charging,
    s.resting?"idle_paused":LAUNCHLAB_MOTION_ADC_GATE?"motion_gated":"always");
  soundPlayer.feedSong();
  Serial.printf("PERF acquisition_core=0 ui_core=%d processing_pct=%.2f max_batch_us=%lu frame_budget_us=%lu max_read_gap_us=%lu stack_free=%lu invalid_frames=%lu lost_events=%lu adc_stalls=%lu max_draw_us=%lu max_effect_us=%lu ui_stalls=%lu stress=%d heap_free=%lu psram_free=%lu usb_drain_timeouts=%lu usb_rejected_commands=%lu frames=%lu whole_frames=%lu unchanged_frames=%lu pushed_rows=%lu row_hashes=%d adc_retimes=%lu\n",
    xPortGetCoreID(),s.processingPercent,(unsigned long)s.maxBatchUs,
    (unsigned long)(uint64_t(StickS3Acquisition::FRAME_BYTES/SOC_ADC_DIGI_RESULT_BYTES)*1000000/StickS3Acquisition::SAMPLE_HZ),(unsigned long)s.maxReadGapUs,
    (unsigned long)s.stackFree,(unsigned long)s.invalidFrames,(unsigned long)s.lostEvents,(unsigned long)s.stalls,
    (unsigned long)maxDrawUs,(unsigned long)maxEffectUs,(unsigned long)uiStalls,stress,
    (unsigned long)ESP.getFreeHeap(),(unsigned long)ESP.getFreePsram(),(unsigned long)UsbTx::drainTimeouts,(unsigned long)usbCommands.rejected,
    (unsigned long)frameRows.frames(),(unsigned long)frameRows.wholeFrames(),(unsigned long)frameRows.unchanged(),
    (unsigned long)frameRows.rows(),frameRows.ready(),(unsigned long)s.retimes);
  heapStatus();nvsStatus();
  const auto tilt=level.reading(millis());const float *acc=level.lastAccel();
  soundPlayer.feedSong();
  Serial.printf("LEVEL_STATUS imu_ready=%d imu_type=%d state=%s degrees=%.2f accel_g=%.3f,%.3f,%.3f samples=%lu rejected=%lu max_poll_us=%lu draw_buffer=%d\n",
    M5.Imu.isEnabled(),int(M5.Imu.getType()),tilt.name(),tilt.degrees,acc[0],acc[1],acc[2],
    (unsigned long)level.samples(),(unsigned long)level.rejected(),(unsigned long)maxImuPollUs,screenReady);
  const auto *session=practice.session();
  const uint32_t now=millis();
  Serial.printf("HISTORY_STATUS records=%u sessions=%u session=%lu session_pulls=%lu session_avg=%.1f generation=%lu pending=%d store_ready=%d save_errors=%lu saves=%lu max_save_us=%lu page=%s view=%u offset=%u demo=%d ui_stack_free=%lu\n",
    practice.size(),practice.sessions(),session?(unsigned long)session->number:0ul,
    session?(unsigned long)session->count:0ul,session?session->mean():0,
    (unsigned long)practice.generation(),historyUnsaved(),practiceStore.ready() || historyLog.isOpen(),
    (unsigned long)saveErrors,(unsigned long)saveCount,(unsigned long)maxSaveUs,
    diagnostics?"signal":historyPage?"history":"live",unsigned(historyView),historyOffset,demo,
    (unsigned long)uxTaskGetStackHighWaterMark(nullptr));
  const bool pendingHistory=historyUnsaved();
  const uint32_t pendingMs=pendingHistory && historyPendingSince?now-historyPendingSince:0;
  const uint32_t quietMs=now-lastAcceptedAt;
  const uint32_t coalesceMs=HistoryCheckpoint::automaticQuietMs(now,imuStill,pendingMs,HISTORY_COALESCE_MS);
  const uint32_t flushDue=quietMs>=coalesceMs?0u:coalesceMs-quietMs;
  const uint32_t retryRemaining=saveError && now-lastSaveTry<HISTORY_SAVE_RETRY_MS?HISTORY_SAVE_RETRY_MS-(now-lastSaveTry):0;
  soundPlayer.feedSong();
  Serial.printf("HISTORY_PENDING unsaved_pulls=%lu pending_ms=%lu flush_due_ms=%lu coalesce_ms=%lu max_pending_ms=%lu retry_remaining_ms=%lu\n",
    (unsigned long)(historyLog.isOpen()?practice.generation()-loggedHistory:practiceStore.pendingCount(practice)),(unsigned long)pendingMs,
    (unsigned long)(pendingHistory?flushDue:0),(unsigned long)coalesceMs,(unsigned long)HistoryCheckpoint::MAX_PENDING_MS,(unsigned long)retryRemaining);
  Serial.printf("POWER_STATUS auto_off_s=%lu shake_wake=%d wake=%s sleep=%s sensor_rail=L2_off_in_battery_standby idle_s=%lu off_in_s=%lu battery_valid=%d battery_mv=%u battery_pct=%d charging=%s max_battery_poll_us=%lu auto_off_inhibited=%d\n",
    (unsigned long)(inactivity.timeout()/1000),shakeToWake,shakeToWake?"shake":"side_key",shakeToWake?"imu_only":"power_off",(unsigned long)(inactivity.elapsed(now)/1000),(unsigned long)((inactivity.remaining(now)+999)/1000),
    battery.valid(now),unsigned(battery.millivolts),battery.valid(now)?battery.percent:-1,
    battery.chargeName(),(unsigned long)maxBatteryPollUs,usbAwake.inhibited(now));
  soundPlayer.feedSong();
  Serial.printf("USB_POWER host_sof=%d host_seen=%d auto_off_inhibited=%d reason=%s power_known=%d last_power_read_ok=%d source=0x%02x host_poll_ms=%lu power_poll_ms=%lu\n",
    usbAwake.sof(),usbAwake.remembered(),usbAwake.inhibited(now),usbAwake.reason(now),usbAwake.powerKnown(now),usbAwake.lastPowerReadOk(),usbAwake.powerBits(),
    (unsigned long)UsbHostAwake::HOST_POLL_MS,(unsigned long)UsbHostAwake::POWER_POLL_MS);
  Serial.printf("POWER_DETAIL uptime_s=%lu cpu_mhz=%lu backlight=%u pm1_cfg_valid=%d pm1_cfg=0x%02x led_enabled=%d current_measurement=unavailable\n",
    (unsigned long)(now/1000),(unsigned long)ESP.getCpuFreqMHz(),unsigned(M5.Display.getBrightness()),
    powerConfigValid,powerConfig,powerConfigValid?int(bool(powerConfig&0x10)):-1);
  soundPlayer.feedSong();
  Serial.printf("POWER_KEY single_click=%s pending=%d clear_failures=%lu\n",
    powerKey().configured()?"firmware_power_off":"pm1_reset",powerKeyRequested,(unsigned long)powerKey().clearFailures());
  Serial.printf("CPU_PM requested=%d enabled=%d min_mhz=%u max_mhz=%d light_sleep=0 error=%s\n",
    LAUNCHLAB_CPU_PM,CpuPower::active(),CpuPower::active()?40u:80u,CpuPower::active()?CpuPower::maxMhz():80,CpuPower::errorName());
  const auto &savers=PowerSavers::settings;
  Serial.printf("POWER_POLICY effective_timeout_s=%lu unused_shake=%d dim_after_ms=%lu dim_ignores_motion=%d dim_backlight=%u rest_after_ms=%lu changed_rows_only=%d imu_poll_ms=%lu level_poll_ms=%lu ui_poll_ms=%lu battery_estimate_mv=%u battery_estimate=voltage_median5\n",
    (unsigned long)(inactivity.activeTimeout()/1000),inactivity.unusedShake(),
    (unsigned long)savers.dimMs,savers.dimIgnoresMotion,unsigned(savers.dimBacklight),(unsigned long)savers.restMs,
    savers.changedRowsOnly,(unsigned long)imuAcquisition.pollMs(),(unsigned long)IdlePowerPolicy::LEVEL_POLL_MS,
    (unsigned long)IdlePowerPolicy::UI_POLL_MS,unsigned(battery.estimateMillivolts));
  // PM1 statistics are written under the shared gate. Do not block status
  // waiting on the IMU owner or sample them concurrently with a PM1 operation.
  if(imuAcquisition.lock()) {
    const auto pm=pm1Idle().stats();imuAcquisition.unlock();
    Serial.printf("PM1_IDLE_STATUS configured=%d seconds=%u fallback_verified=%d wake_retries=%lu recovered_reads=%lu read_failures=%lu write_failures=%lu operation_failures=%lu config_failures=%lu\n",
      pm.configured,unsigned(pm.seconds),pm.fallbackVerified,(unsigned long)pm.wakeRetries,
      (unsigned long)pm.recoveredReads,(unsigned long)pm.readFailures,(unsigned long)pm.writeFailures,
      (unsigned long)pm.operationFailures,(unsigned long)pm.configFailures);
  }
  const auto imu=imuAcquisition.snapshot();
  const auto &activity=imu.activity;
  soundPlayer.feedSong();
  Serial.printf("SENSOR_IDLE enabled=%d resting=%d sensor_power=on_shared_rail adc_pause_after_ms=%lu pauses=%lu resumes=%lu experimental=1\n",
    LAUNCHLAB_MOTION_ADC_GATE,s.resting,(unsigned long)SensorIdle::IDLE_MS,
    (unsigned long)sensorIdle.pauses(),(unsigned long)sensorIdle.resumes());
  Serial.printf("MOTION_ACTIVITY valid=%d fresh=%d moving=%d gyro_dps=%.3f accel_change_g=%.4f gyro_on_dps=%.2f accel_on_g=%.3f confirm_ms=%lu idle_ms=%lu unused_shake=%d off_in_s=%lu\n",
    activity.valid,activity.fresh(esp_timer_get_time()),activity.moving,activity.gyroDps,activity.accelChangeG,
    MotionActivity::GYRO_ON,MotionActivity::ACCEL_ON,(unsigned long)(MotionActivity::CONFIRM_US/1000),
    (unsigned long)inactivity.elapsed(now),inactivity.unusedShake(),(unsigned long)((inactivity.remaining(now)+999)/1000));
  soundPlayer.feedSong();
  Serial.printf("MOUNT_STATUS selected=%s imu_frame=%s accel_gyro_frame=launcher raw_imu_frame=device display_flip=%d\n",
    MountOrientation::label(mountMode),MountOrientation::label(imu.mount),displayFlipped);
  Serial.printf("IMU_RESTORE_STATUS needed=%d failures=%lu capture_retries=%lu\n",motionRestoreNeeded,(unsigned long)motionRestoreFailures,(unsigned long)motionCaptureRetries);
  Serial.printf("IMU_STARTUP_STATUS attempts=%lu last_try_ms=%lu last_paired=%d last_success=%d retry_ms=%lu\n",
    (unsigned long)motionInitAttempts,(unsigned long)lastMotionInit,motionInitPaired,motionInitSuccess,
    (unsigned long)MOTION_INIT_RETRY_MS);
  soundPlayer.feedSong();
  Serial.printf("MOTION_STATUS imu_core=0 imu_task=%d paired_samples=%lu accel_samples=%lu max_gap_us=%lu gaps=%lu max_poll_us=%lu stack_free=%lu gate_misses=%lu late_polls=%lu missed_polls=%lu latest=%lu quality=%s pending=%d ref=%lu ref_rpm=%.1f ref_store_ready=%d ref_load_error=%d dropped=%lu demo=%d feedback=%d\n",
    imuAcquisition.running(),(unsigned long)imu.pairedSamples,(unsigned long)imu.accelSamples,
    (unsigned long)imu.maxGapUs,(unsigned long)imu.gaps,(unsigned long)imu.maxPollUs,(unsigned long)imu.stackFree,(unsigned long)imu.gateMisses,(unsigned long)imu.latePolls,(unsigned long)imu.missedPolls,
    (unsigned long)latestMotion.number,LaunchMotion::name(latestMotion.quality),motionPending,
    (unsigned long)referenceMotion.number,referenceMotion.rpm,motionStore.ready(),referenceError,
    (unsigned long)motionDrops,motionDemo,launchFeedback.shown());
  Serial.printf("ORIENTATION_STATUS algorithm=VQF6D position=disabled absolute_heading=disabled ready=%d rest=%d updates=%lu resets=%lu max_fusion_us=%lu bias_dps=%.4f,%.4f,%.4f bias_sigma_dps=%.4f\n",
    imu.orientationReady,imu.rest,(unsigned long)imu.fusionSamples,(unsigned long)imu.fusionResets,
    (unsigned long)imu.maxFusionUs,imu.bias[0],imu.bias[1],imu.bias[2],imu.biasSigma);
  soundPlayer.feedSong();
  Serial.printf("I2C_RECOVERY bus=internal result=%s pulses=%u sda_was=%d scl_was=%d\n",I2cBusRecovery::name(i2cRecovery),i2cRecoveryPulses,i2cSdaWas,i2cSclWas);
  Serial.printf("IMU_FIFO_STATUS reads=%lu errors=%lu skipped_frames=%lu anchors=%lu max_bytes=%lu period_us=%.1f gyro_samples=%lu accel_samples=%lu flash_quiet_polls=%lu length_errors=%lu data_errors=%lu parse_errors=%lu oversize=%lu overflows=%lu stalls=%lu last_stall_us=%lu last_stall_ms=%lu last_error_bytes=%lu last_error_offset=%lu last_error_ms=%lu last_quiet_ms=%lu..%lu\n",
    (unsigned long)imu.fifoReads,(unsigned long)imu.fifoErrors,(unsigned long)imu.fifoSkipped,(unsigned long)imu.fifoAnchors,
    (unsigned long)imu.fifoMaxBytes,imu.fifoPeriodUs,(unsigned long)imu.pairedSamples,(unsigned long)imu.accelSamples,(unsigned long)imu.quietPolls,
    (unsigned long)imu.fifoLengthErrors,(unsigned long)imu.fifoDataErrors,(unsigned long)imu.fifoParseErrors,(unsigned long)imu.fifoOversize,(unsigned long)imu.fifoOverflows,
    (unsigned long)imu.fifoStalls,(unsigned long)imu.lastStallUs,(unsigned long)imu.lastStallMs,
    (unsigned long)imu.lastErrorBytes,(unsigned long)imu.lastErrorOffset,(unsigned long)imu.lastErrorMs,
    (unsigned long)imuAcquisition.quietBeganMs(),(unsigned long)imuAcquisition.quietEndedMs());
  soundPlayer.feedSong();
  Serial.printf("MOTION_CLIP accel_range_g=%.0f gyro_range_dps=%.0f samples=%lu max_run=%lu last_run=%lu last_ms=%lu last_axes=0x%02lx\n",
    accelRange().fullScaleG(),StickS3AccelRange::GYRO_FULL_SCALE_DPS,(unsigned long)imu.clipSamples,(unsigned long)imu.maxClipRun,
    (unsigned long)imu.lastClipRun,(unsigned long)imu.lastClipMs,(unsigned long)imu.lastClipAxes);
  for(unsigned i=imu.gapNext>StickS3MotionAcquisition::Snapshot::GAPS?imu.gapNext-StickS3MotionAcquisition::Snapshot::GAPS:0;i<imu.gapNext;++i) {
    const auto &g=imu.gapLog[i%StickS3MotionAcquisition::Snapshot::GAPS];
    Serial.printf("MOTION_GAP n=%u at_ms=%lu gap_us=%lu polls=%lu empty_polls=%lu max_period_us=%lu max_lock_us=%lu max_poll_us=%lu max_ring_us=%lu\n",
      i+1,(unsigned long)g.atMs,(unsigned long)g.gapUs,(unsigned long)g.polls,(unsigned long)g.emptyPolls,
      (unsigned long)g.periodUs,(unsigned long)g.lockUs,(unsigned long)g.pollUs,(unsigned long)g.ringUs);
  }
}

// No serial reader is needed: isPlugged() uses IDF's SOF monitor, not CDC I/O.
LOOP_HELPER static void pollUsbAwake(uint32_t now,const Snapshot &s,bool force=false) {
  if(!force && !usbAwake.hostPollDue(now))return;
  usbAwake.sampleHost(now,HWCDC::isPlugged());
  if(usbAwake.powerPollDue(now) && s.phase!=AnalogTachometer::Phase::Launch) {
    uint8_t source=0;bool ok=false;
    if(imuAcquisition.lock()) {
      // Checked PWR_SRC read: wrappers that return zero also hide I2C errors.
      ok=pm1Idle().read(0x04,&source,1);
      imuAcquisition.unlock();
    }
    usbAwake.samplePower(now,ok,source);
  }
  const bool inhibited=usbAwake.inhibited(now);
  // A confirmed computer connection establishes use, even if the initial
  // optimistic SOF already inhibited shutdown on the preceding poll.
  if(inhibited && usbAwake.remembered() && usbAwake.powerKnown(now) &&
     (usbAwake.powerBits()&UsbHostAwake::VIN_MASK) && inactivity.unusedShake())inactivity.touch(now);
  if(inhibited!=usbAutoOffInhibited) {
    usbAutoOffInhibited=inhibited;
    // A disconnect starts a full ordinary battery timeout, not an overdue
    // timer accumulated during a long computer session. Touch only on edges.
    // A transient, unconfirmed boot SOF must not turn an accidental shake
    // wake into a full practice timeout. Confirmed detach was promoted above.
    if(!inactivity.unusedShake())inactivity.touch(now);
    lastShutdownTry=0;
    Serial.printf("USB_AUTO_OFF inhibited=%d reason=%s sof=%d host_seen=%d power_known=%d source=0x%02x\n",
      inhibited,usbAwake.reason(now),usbAwake.sof(),usbAwake.remembered(),usbAwake.powerKnown(now),usbAwake.powerBits());
  }
}

// The corner battery (Battery icon) on the Menu and Settings pages
// (Controls::showsCornerBattery), never over the tournament or the
// diagnostics. Editing the row previews the choice. The live Main page shows
// it only while the unit charges (0.20.9), not over a recap or the demo.
static ControlsUI::CornerBattery cornerBattery(uint32_t now) {
  const bool editing=controls.page==Controls::Page::Edit && controls.setting==unsigned(Controls::Setting::BatteryIcon);
  const bool chargingMain=Controls::showsChargingBattery(controls.page) && battery.charging && !historyPage && !launchFeedback.shown();
  const bool shown=(editing?bool(controls.draft):batteryIcon) && !tournamentMode && !diagnostics &&
    (Controls::showsCornerBattery(controls.page) || chargingMain);
  return shown?ControlsUI::cornerBattery(battery.valid(now),battery.percent,battery.charging):ControlsUI::CornerBattery{};
}

LOOP_HELPER static void pollBattery(uint32_t now,const Snapshot &s) {
  if(s.phase==AnalogTachometer::Phase::Launch || (batteryPolled && now-lastBatteryPoll<5000))return;
  if(!imuAcquisition.lock())return;
  batteryPolled=true;lastBatteryPoll=now;
  const int64_t started=esp_timer_get_time();
  uint16_t mv=0;uint8_t bits=0;
  bool voltageRead=false,chargeRead=false;
  if(pm1Idle().ensureAwake()) {
    voltageRead=M5.Power.M5pm1.getBatteryVoltage(&mv);
    chargeRead=M5.Power.M5pm1.getGPIOInputBits(&bits);
  }
  powerConfigValid=pm1Idle().read(0x06,&powerConfig,1);
  imuAcquisition.unlock();
  battery.update(mv,voltageRead,chargeRead,bits,now);
  maxBatteryPollUs=std::max(maxBatteryPollUs,uint32_t(esp_timer_get_time()-started));
  if((historyPage && historyView==PracticeUI::View::Battery) || cornerBattery(now)!=drawnCornerBattery)dirty=true;
}

// The pairing number and a wipe always show; so does anything being diagnosed.
static bool displayDark(uint32_t now) {
  if(!darkDisplay.dark(now) || wipeBlocked || diagnostics || stress)return false;
  uint32_t number=0;bool automatic=false;
  return !BleLink::comparison(number,automatic);
}

// A press that only wakes the screen does nothing else: its click comes at release, which the latch ignores.
static void wakeDisplayOnPress(bool pressed) {
  if(!pressed || !darkDisplay.press(millis()))return;
  gestureA.consumed=gestureB.consumed=true;dirty=true;
}

static void tickDarkDisplay(uint32_t now) {
  if(darkDisplay.requested && !BleLink::connected()){darkDisplay.set(false);dirty=true;}
  darkDisplay.tick(now);
}

LOOP_HELPER static void tickDisplayPower(uint32_t now,const Snapshot &s) {
  // Preserve the electrical conditions during a measured pull. A pull while
  // dimmed restores its feedback brightness only after measurement completes.
  if(s.phase==AnalogTachometer::Phase::Launch ||
     (s.phase==AnalogTachometer::Phase::Ready && !s.opticalIdle))return;
#if LAUNCHLAB_POWER_LAB
  // A fixed lab backlight, never dimmed; 0 puts the panel to sleep.
  if(Lab::running && Lab::knobs.backlight>=0) {
    const uint8_t target=(unsigned(Lab::knobs.backlight)*255+50)/100;
    if(M5.Display.getBrightness()==target && Lab::displayAsleep==!target)return;
    acquisition.displayBoundary(true);
    if(!target){M5.Display.setBrightness(0);M5.Display.sleep();Lab::displayAsleep=true;}
    else{if(Lab::displayAsleep){M5.Display.wakeup();frameRows.invalidate();Lab::displayAsleep=false;}M5.Display.setBrightness(target);}
    acquisition.displayBoundary(false);
    Serial.printf("LAB_DISPLAY backlight_pct=%d asleep=%d\n",Lab::knobs.backlight,Lab::displayAsleep);
    return;
  }
  if(Lab::displayAsleep){M5.Display.wakeup();frameRows.invalidate();Lab::displayAsleep=false;dirty=true;}
#endif
  const auto &savers=PowerSavers::settings;
  const uint8_t selected=controls.page==Controls::Page::Edit && controls.setting==2?
    controls.draft:brightnessPercent;
  const uint32_t idle=savers.dimIgnoresMotion?inactivity.sinceUse(now):inactivity.elapsed(now);
  const uint8_t percent=displayDark(now)?0:IdlePowerPolicy::brightness(selected,idle,usbAwake.inhibited(now),launchFeedback.shown(),savers.dimMs);
  const uint8_t target=percent && percent<selected && savers.dimBacklight?savers.dimBacklight:(unsigned(percent)*255+50)/100;
  if(M5.Display.getBrightness()==target)return;
  acquisition.displayBoundary(true);M5.Display.setBrightness(target);acquisition.displayBoundary(false);
  Serial.printf("DISPLAY_POWER selected_pct=%u actual_pct=%u backlight=%u idle_ms=%lu dimmed=%d\n",
    selected,percent,unsigned(target),(unsigned long)idle,percent<selected);
}

static void drawBattery(lgfx::LGFXBase &g,uint32_t now) {
  ControlsUI::battery(g,battery.valid(now),battery.percent,battery.millivolts,battery.chargeKnown,battery.charging);
}
// The unit's ID is its factory MAC, which is also its USB serial number.
static void drawAbout(lgfx::LGFXBase &g) {
  uint8_t mac[6]={};char id[18]="--";
  if(esp_efuse_mac_get_default(mac)==ESP_OK)snprintf(id,sizeof(id),"%02X:%02X:%02X:%02X:%02X:%02X",mac[0],mac[1],mac[2],mac[3],mac[4],mac[5]);
  ControlsUI::about(g,id,practice.size());
}

// The applied value of each editable Settings row, in Controls::Setting order.
static uint8_t settingValue(unsigned row) {
  using S=Controls::Setting;
  switch(S(row)) {
    case S::Sleep:return inactivity.minutes();
    case S::Rpm:return uint8_t(rpmEstimator);
    case S::Brightness:return brightnessPercent;
    case S::Flip:return uint8_t(displayFlipped);
    case S::Sensor:return uint8_t(sensorProfile);
    case S::Theme:return uint8_t(themeLibrary.effective(appearance.theme));
    case S::BestEffect:return uint8_t(appearance.effect);
    case S::Celebrate:return uint8_t(milestones.mode());
    case S::Sound:return uint8_t(appearance.sound);
    case S::Mount:return uint8_t(mountMode);
    case S::ShakeWake:return uint8_t(shakeToWake);
    case S::BatteryIcon:return uint8_t(batteryIcon);
    case S::Bluetooth:return uint8_t(bluetoothOn);
    case S::WipeAll:case S::About:break;
  }
  return 0;
}
static void drawSettings(lgfx::LGFXBase &g) {
  uint8_t values[Controls::SETTING_COUNT];
  for(unsigned i=0;i<Controls::SETTING_COUNT;++i)values[i]=settingValue(i);
  ControlsUI::settings(g,controls,values);
}

LOOP_HELPER static void exportSignal() {
  if(!acquisition.storage() || !acquisition.request(Action::Suspend)) {
    Serial.println("RAW_ERROR acquisition_suspend_failed");return;
  }
  const Snapshot s=acquisition.snapshot();
  if(s.ringCount) {
    Serial.printf("FLIGHT_EXPORT samples=%lu end_detector_us=%llu state=%s launches=%lu gpio=%u display_blanking=0\n",
      (unsigned long)s.ringCount,(unsigned long long)s.detectorUs,s.stateName(),(unsigned long)s.launches,s.pin);
    opticalTransferRaw(acquisition.storage(),StickS3Acquisition::RING_SAMPLES,s.ringFirst,s.ringCount,
      int64_t(s.ringCount)*1000000/ANALOG_SAMPLE_HZ,0,0,true,ESP_OK,false);
  } else Serial.println("RAW_ERROR no_flight_record");
  if(!acquisition.request(Action::Resume))Serial.println("ADC_ERROR resume_failed");
  dirty=true;
}

// The RPM detector would measure a burst now: not in its rearm second.
static bool wearDetectorReady(const Snapshot &s) {
  return s.ready && !s.signalFault && !s.suspended && s.phase==AnalogTachometer::Phase::Ready;
}
// Wear check's level, as the other Mounting would read the unit: held off
// level here but level there, the page suggests the other Mounting.
LOOP_HELPER static void observeWearMount(const StickS3Level::Reading &tilt) {
  const auto other=liveMount==MountOrientation::Mode::Sidecar?MountOrientation::Mode::Top:MountOrientation::Mode::Sidecar;
  const bool hinted=controls.wear.mountHint();
  controls.wear.observeMount(millis(),WearCheck::Tilt(tilt),WearCheck::Tilt(level.reading(millis(),
    [other](const float *in,float *out){MountOrientation::remapVector(liveMount,other,in,out);})));
  if(controls.wear.mountHint()==hinted)return;
  dirty=true;
  Serial.printf("WEAR_CHECK_MOUNT_HINT shown=%d mount=%s\n",controls.wear.mountHint(),MountOrientation::label(liveMount));
}
// A on the Wear check page starts the check over: say what pressed it.
LOOP_HELPER static void noteWearTap(const char *source) {
  if(controls.page!=Controls::Page::WearCheck)return;
  Serial.printf("WEAR_CHECK_RESET source=%s stage=%s pulls=%u\n",source,
    WearCheck::stageName(controls.wear.stage()),controls.wear.totalAccepted());
}
// Every burst or unmeasured pull on the Wear check page: accepted, completed
// or rejected retractions, the pull out (extension, never counted), the string
// let go before LET GO (early_release) and an unmeasured retraction (missed).
LOOP_HELPER static void logWearPull(WearCheck::Stage stageBefore,WearCheck::Outcome outcome,float rpm) {
  inactivity.touch(millis());
  Serial.printf("WEAR_CHECK_PULL stage=%s pull=%u/%u outcome=%s rpm=%.1f tilt_deg=%.2f\n",
    WearCheck::stageName(stageBefore),
    stageBefore<WearCheck::Stage::Complete?controls.wear.stageCount(unsigned(stageBefore)):WearCheck::PULLS_PER_STAGE,
    WearCheck::PULLS_PER_STAGE,WearCheck::outcomeName(outcome),rpm,controls.wear.lastTiltDegrees());
}

static void drawLiveLevel(lgfx::LGFXBase &view,int cx) {
  drawnLevel=StickS3Level::forDisplay(level.reading(millis()),visibleDisplayFlipped());
  ScreensUI::level(view,ui(),cx,drawnLevel);
}

// The recap's label: NEW BEST for a personal best, otherwise the milestone
// the pull reached; null when the recap celebrates nothing.
static const char *celebrationBadge() {
  static char text[24];
  if(motionDemo || !bestEffect.badge())return nullptr;
  if(bestEffect.best())return "NEW BEST";
  Milestones::milestoneText(text,sizeof(text),bestEffect.milestone());return text;
}
LOOP_HELPER static void draw(const Snapshot &s) {
  const int64_t started=esp_timer_get_time();
  const Palette::Colors colors=ui();
  ControlsUI::colors=colors;ControlsUI::themeLabel=[](Appearance::Theme t){return themeLibrary.label(t);};ControlsUI::milestones=&milestones;
  ControlsUI::runtime=VERSION;
  const uint32_t replayFrameElapsed=launchFeedback.replayElapsed(millis());
  const bool replayWasStarted=launchFeedback.replayStarted();
  auto &view=screenReady?static_cast<lgfx::LGFXBase &>(screen):static_cast<lgfx::LGFXBase &>(M5.Display);
  if(!screenReady){acquisition.displayBoundary(true);M5.Display.startWrite();}
  view.fillScreen(colors.background);
  const int cx=view.width()/2;
  view.setTextDatum(top_center);
  view.setTextColor(colors.text,colors.background);
  if(!tournamentMode && diagnostics)
    ScreensUI::diagnosticsHeader(view,colors,newSessionAt && millis()-newSessionAt<1500,s.stateName(),s.ready && !s.signalFault);
  view.setTextColor(colors.text,colors.background);
  if(tournamentMode) {
    ScreensUI::tournament(view,colors,s.ready && !s.signalFault,tournamentView==TournamentView::RecordingOnly,s.valid,s.resultRpm);
    if(int32_t(tournamentHintUntil-millis())>0)ControlsUI::footer(view,"B View  Hold A Exit");
  } else if(diagnostics) {
    ScreensUI::diagnostics(view,s.pin,s.last,s.minimum,s.maximum,s.rate);
  } else if(historyPage) {
    view.fillScreen(colors.background);
    switch(controls.page) {
      case Controls::Page::Menu:ControlsUI::list(view,"Menu",ControlsUI::MENU,Controls::MENU_COUNT,controls.menu,Controls::MENU_GROUPS);break;
      case Controls::Page::HistoryMenu:ControlsUI::list(view,"History",ControlsUI::HISTORY,4,controls.history);break;
      case Controls::Page::Settings:drawSettings(view);break;
      case Controls::Page::Edit:ControlsUI::editor(view,controls,settingsSaveError,
        (controls.setting==1 && controls.draft!=uint8_t(rpmEstimator)) ||
        (controls.setting==4 && controls.draft!=uint8_t(sensorProfile)));
        // The previewed effect frames the value text inside its card.
        if(screenReady && controls.setting==unsigned(Controls::Setting::BestEffect) && editorEffect.badge()) {
          const int64_t effectStarted=esp_timer_get_time();effectReadUs=effectStarted;BestEffectUI::Renderer::Anchor card;
          card.top=72;card.bottom=128;card.left=8;card.right=view.width()-9;
          drawEffect(editorEffect.effect(),editorEffect.elapsed(millis()),card,colors);
          maxEffectUs=std::max(maxEffectUs,uint32_t(esp_timer_get_time()-effectStarted));
        }
        break;
      case Controls::Page::NewSession:ControlsUI::session(view,controls.startSession);break;
      case Controls::Page::Battery:drawBattery(view,millis());break;
      case Controls::Page::About:drawAbout(view);break;
      case Controls::Page::Wipe:ControlsUI::wipe(view,wipeConfirmation,millis(),wipeFailed,wipeBlocked,wipeComplete);break;
      case Controls::Page::MicRpm:
        MicView::draw(view,micListener.trace(),micPageState(),colors);
        break;
      case Controls::Page::WearCheck: {
        const auto rawTilt=level.reading(millis());
        drawnLevel=StickS3Level::forDisplay(rawTilt,visibleDisplayFlipped());
        ControlsUI::wearCheck(view,controls.wear,WearCheck::Tilt(rawTilt),WearCheck::Tilt(drawnLevel),wearDetectorReady(s),
          liveMount==MountOrientation::Mode::Sidecar?"Sidecar mount":"Top mount",
          liveMount==MountOrientation::Mode::Sidecar?"Top install?":"Sidecar install?");
        break;
      }
      case Controls::Page::Bluetooth:ControlsUI::bluetoothPage(view,controls.bluetoothRow,bluetoothOn,BleLink::connected(),BattlePass::NAME,BleLink::bondCount());break;
      case Controls::Page::ForgetPhones:ControlsUI::forgetPhones(view,controls.forgetChosen);break;
      case Controls::Page::EnableBluetooth:ControlsUI::enableBluetooth(view,controls.enableChosen);break;
      default:PracticeUI::draw(view,demo?demoPractice:practice,historyView,historyOffset,demo,colors);break;
    }
  } else if(launchFeedback.shown()) {
    view.fillScreen(colors.background);
    MotionUI::feedback(view,motionDemo?demoMotion:latestMotion,
      motionPending && !motionDemo,motionDemo,MotionReplay::playbackProgress(motionDemo?demoMotion:latestMotion,
        launchFeedback.position(replayFrameElapsed)),visibleDisplayFlipped(),colors,celebrationBadge(),
      motionDemo?MotionUI::demoCurve(demoMotion.rpm):latestCurve);
    ControlsUI::footer(view,"A Main  B Menu");
    // Direct-draw fallback stays functional without reading the hardware LCD.
    if(screenReady && !motionDemo && !motionPending && bestEffect.badge()) {
      const int64_t effectStarted=esp_timer_get_time();effectReadUs=effectStarted;
#if LAUNCHLAB_HIL
      if(!hilFxDraw(static_cast<uint16_t *>(screen.getBuffer()),screen.width(),screen.height(),bestEffect.elapsed(millis()),colors.accent,colors.background))
#endif
      drawEffect(bestEffect.effect(),bestEffect.elapsed(millis()),BestEffectUI::Renderer::Anchor(),colors);
      maxEffectUs=std::max(maxEffectUs,uint32_t(esp_timer_get_time()-effectStarted));
#if LAUNCHLAB_HIL
      if(effectFrames.count<128 && bestEffect.moving(millis())){
        effectFrames.elapsed[effectFrames.count]=uint16_t(bestEffect.elapsed(millis()));
        effectFrames.us[effectFrames.count++]=uint16_t(std::min<int64_t>(65535,esp_timer_get_time()-effectStarted));}
#ifdef BEST_EFFECT_PROFILE
      if(effectStages.count<64 && bestEffect.moving(millis())) {
        const unsigned n=effectStages.count++;effectStages.elapsed[n]=uint16_t(bestEffect.elapsed(millis()));
        effectStages.us[n]=uint32_t(esp_timer_get_time()-effectStarted);
        std::memcpy(effectStages.cycles[n],bestEffectRenderer.stage,sizeof(effectStages.cycles[n]));
      }
#endif
#endif
    }
  } else {
    const bool sessionNotice=newSessionAt && millis()-newSessionAt<1500 &&
      s.ready && !s.signalFault && !s.suspended && s.phase==AnalogTachometer::Phase::Ready;
    const char *status=sessionNotice?"New session ready":s.stateName();
    ScreensUI::live(view,colors,status,sessionNotice?ScreensUI::Tone::Text:s.ready && !s.signalFault?ScreensUI::Tone::Ready:ScreensUI::Tone::Warning,
      s.valid,s.resultRpm);
    drawLiveLevel(view,cx);
  }
  if(!tournamentMode && (diagnostics || (!historyPage && !launchFeedback.shown()))) {
    view.setTextDatum(top_center);view.setTextColor(colors.muted,colors.background);
    ControlsUI::footer(view,"A Recap  B Menu");
  }
  const uint32_t now=millis();
  if(M5.BtnA.isPressed() && !gestureA.consumed && (tournamentMode || (controls.page==Controls::Page::Main && !launchFeedback.shown())))
    ControlsUI::hold(view,tournamentMode?"Exit tournament":"Enter tournament",now-M5.BtnA.lastChange(),1000);
  else if(M5.BtnB.isPressed() && !gestureB.consumed && (controls.page!=Controls::Page::Main || launchFeedback.shown()) && !tournamentMode)
    ControlsUI::hold(view,controls.page==Controls::Page::Edit?"Cancel change":"Back",now-M5.BtnB.lastChange(),1000);
  drawnCornerBattery=cornerBattery(now);ControlsUI::cornerBattery(view,drawnCornerBattery);
  BleLink::drawIcon(view,colors.muted,colors.ready,colors.background,colors.text);
  if(BluetoothSetting::restartNeeded(bluetoothOn,bluetoothAtBoot))ControlsUI::restarting(view);
  {uint32_t pairingNumber=0;bool pairingAutomatic=false;if(BleLink::comparison(pairingNumber,pairingAutomatic))ControlsUI::comparison(view,pairingNumber,pairingAutomatic);}
  // An internal canvas is pushed by DMA, which endWrite does not wait for.
  // Wait so the transfer stays inside the boundary marks and the next frame
  // cannot overwrite pixels still being sent.
  if(screenReady) {
    acquisition.displayBoundary(true);M5.Display.startWrite();
    // Only the rows that changed since the panel's last frame, nothing when
    // none did (frame_rows.h); whole after a rotation.
    if(M5.Display.getRotation()!=frameRotation){frameRotation=M5.Display.getRotation();frameRows.invalidate();}
    FrameRows::Span rows;rows.count=screen.height();rows.whole=true;
    if(PowerSavers::settings.changedRowsOnly)rows=frameRows.changed(screen.getBuffer(),screen.width(),screen.height(),millis());
    else frameRows.invalidate();
    if(rows.whole)screen.pushSprite(0,0);
    else if(rows.any()){M5.Display.setClipRect(0,rows.first,screen.width(),rows.count);screen.pushSprite(0,0);M5.Display.clearClipRect();}
    M5.Display.waitDMA();
#if LAUNCHLAB_POWER_LAB
    Lab::rows+=uint32_t(rows.count);
#endif
  }
#if LAUNCHLAB_POWER_LAB
  ++Lab::frames;
#endif
  M5.Display.endWrite();
  if(effectReadUs){presentLagUs=uint32_t(esp_timer_get_time()-effectReadUs);effectReadUs=0;}
  acquisition.displayBoundary(false);
  if(!tournamentMode && !diagnostics && !historyPage && launchFeedback.shown() && !motionDemo && !motionPending)
    bestEffect.presented(millis());
  // The sound starts with the effect's first presented frame. The editor's
  // preview holds its first frame until its sound is rendered, so the two
  // start together.
  if(controls.page==Controls::Page::Edit && controls.setting==unsigned(Controls::Setting::BestEffect) &&
     (appearance.sound==Appearance::Sound::Off || !editorEffect.badge() || soundPlayer.prepared(editorEffect.effect())))editorEffect.presented(millis());
  if(bestEffect.takeCue()) {
    Serial.printf("CELEBRATION_START launch=%lu effect=%s milestone=%u best=%d\n",(unsigned long)latestMotion.number,
      Appearance::label(bestEffect.effect()),unsigned(bestEffect.milestone()),bestEffect.best());
    requestSound(bestEffect.effect(),appearance.sound,true);
    // Keep this pick's clip ready until its first frame has started playback.
    // Only a presented Best effect consumes Random's next pick; a milestone
    // plays its own effect.
    if(appearance.effect==Appearance::Effect::Random && !bestEffect.milestone())upcomingEffect=EffectSet::pick(esp_random(),bestEffect.effect(),effectSet.mask());
    // A milestone uses up its row's pick.
    if(bestEffect.milestone())nextMilestonePick(bestEffect.milestone(),bestEffect.effect());
  }
  if(editorEffect.takeCue())requestSound(editorEffect.effect(),appearance.sound,false);
  launchFeedback.replayPresented(millis(),!tournamentMode && !diagnostics && !historyPage &&
    (!motionPending || motionDemo) && (motionDemo?demoMotion:latestMotion).valid() && (motionDemo?demoMotion:latestMotion).fused,replayFrameElapsed);
  if(!motionDemo && !replayWasStarted && launchFeedback.replayStarted())
    Serial.printf("RECAP_PRESENT launch=%lu after_end_ms=%lu draw_us=%lu\n",(unsigned long)latestMotion.number,
      (unsigned long)((esp_timer_get_time()-motionEnd)/1000),(unsigned long)(esp_timer_get_time()-started));
  maxDrawUs=std::max(maxDrawUs,uint32_t(esp_timer_get_time()-started));
}

LOOP_HELPER static void pollLevel(uint32_t now) {
  // Fusion remains continuous on its own task. The UI needs fresh level data
  // only at 50 Hz, rather than copying the full snapshot on every loop pass.
  if(now-lastImuPoll<IdlePowerPolicy::LEVEL_POLL_MS)return;
  lastImuPoll=now;
  if(imuAcquisition.running()) {
    const auto sample=imuAcquisition.snapshot();
    const uint64_t clockUs=esp_timer_get_time();
    if(sample.activity.fresh(clockUs) && sample.activity.lastMotionUs>lastActivityMotionUs &&
       clockUs>=sample.activity.lastMotionUs && clockUs-sample.activity.lastMotionUs<=MotionActivity::FRESH_US) {
      lastActivityMotionUs=sample.activity.lastMotionUs;inactivity.motion(now);
    }
    imuStill.observe(now,sample.activity.fresh(clockUs) && !sample.activity.moving);
    if(sample.fusedUs && sample.fusedUs!=lastLevelSampleUs) {
      lastLevelSampleUs=sample.fusedUs;
      if(sample.orientationReady)level.feed(sample.gravity[0],sample.gravity[1],sample.gravity[2],uint32_t(sample.fusedUs/1000));
      else level.feed(0,0,0,uint32_t(sample.fusedUs/1000));
    }
    return;
  }
  imuStill.observe(now,false);
  if(!M5.Imu.isEnabled())return;
  const int64_t started=esp_timer_get_time();
  // update's returned accel bit establishes freshness; cached data is not a new sample.
  if(M5.Imu.update() & m5::IMU_Class::sensor_mask_accel) {
    const auto data=M5.Imu.getImuData();
    const auto &range=accelRange();
    const float native[3]={range.toG(data.accel.x),range.toG(data.accel.y),range.toG(data.accel.z)};float mapped[3];
    MountOrientation::mapVector(liveMount,native,mapped);
    level.feed(mapped[0],mapped[1],mapped[2],millis());
  }
  maxImuPollUs=std::max(maxImuPollUs,uint32_t(esp_timer_get_time()-started));
}

LOOP_HELPER static void exportScreen() {
  if(!screenReady){Serial.println("SNAP_ERROR no_draw_buffer");return;}
  // Export the last displayed frame, including its frozen level during a pull.
  const unsigned width=screen.width(),height=screen.height();
  Serial.printf("SNAP %u %u %u\n",width,height,width*height*2);
  uint8_t row[240*2];
  for(unsigned y=0;y<height;++y) {
    for(unsigned x=0;x<width;++x) {
      const uint16_t pixel=screen.readPixel(x,y);row[x*2]=pixel>>8;row[x*2+1]=pixel;
    }
    Serial.write(row,width*2);
  }
}

static void toggleFeedback() {
  if(tournamentMode)return;
  bestEffect.clear();
  historyPage=diagnostics=motionDemo=demo=false;
  launchFeedback.toggle(millis(),latestMotion.number!=0,MotionReplay::playbackDurationMs(latestMotion));dirty=true;
  Serial.printf("MAIN_FEEDBACK shown=%d reason=button t_ms=%lu\n",launchFeedback.shown(),(unsigned long)millis());
}

static void buttonA();
static void buttonB();
LOOP_HELPER static void toggleHistory(){buttonB();}
LOOP_HELPER static void nextView(){buttonA();}
// The pull's RPM turn by turn, copied by the optical task with its result.
LOOP_HELPER static void takeCurve(const Snapshot &event) {
  if(!acquisition.curve(event.revision,latestCurve))latestCurve.clear();
  const auto &c=latestCurve;unsigned peak=0;for(unsigned i=1;i<c.count;++i)if(c.rpm[i]>c.rpm[peak])peak=i;
  Serial.printf("RPM_CURVE launch=%lu points=%u stride=%u peak_rpm=%u peak_ms=%u last_ms=%u\n",(unsigned long)practice.recent()->number,
    unsigned(c.count),unsigned(c.stride),c.count?unsigned(c.rpm[peak]):0u,c.count?unsigned(c.ms[peak]):0u,c.count?unsigned(c.ms[c.count-1]):0u);
}
LOOP_HELPER static void prepareMotion(const Snapshot &event) {
  lastAcceptedAt=millis();if(!historyPendingSince)historyPendingSince=lastAcceptedAt;
  if(motionPending)++motionDrops;
  latestMotion={};latestMotion.number=practice.recent()->number;latestMotion.rpm=event.resultRpm;
  takeCurve(event);
  const bool beat=bestStore.ready() && personalBests.observe(unsigned(event.sensorProfile),unsigned(event.estimator),event.valid,event.resultRpm);
  // The selected estimator's RPM is the pull's RPM, for milestones as for bests.
  const bool visible=!tournamentMode && !historyPage && !diagnostics;
  const auto decision=visible?Milestones::decide(milestones,event.valid,event.resultRpm,beat,
    beat && milestones.mode()!=Milestones::Mode::Milestones?celebrationEffect():Appearance::Effect::Off,milestonePicks()):Milestones::Decision{};
  bestEffect.queue(decision.show,latestMotion.number,decision.effect,decision.best,decision.milestone);
  Serial.printf("CELEBRATION launch=%lu rpm=%.1f shown_rpm=%ld valid=%d mode=%s best=%d milestone=%u effect=%s celebrate=%d\n",(unsigned long)latestMotion.number,
    event.resultRpm,Milestones::shown(event.resultRpm),event.valid,Milestones::name(milestones.mode()),beat,unsigned(decision.milestone),
    decision.show?Appearance::playedLabel(decision.effect):"none",decision.show);
  motionStart=event.burstStartHostUs;motionEnd=event.burstEndHostUs;motionPending=true;
  // Update the recording regardless of navigation, without stealing an edit
  // or revealing results in tournament. Main/recap alone follows new pulls.
  if(!tournamentMode && !historyPage && !diagnostics) {
    motionDemo=demo=false;launchFeedback.show(millis());
  }
  dirty=true;
}
LOOP_HELPER static void finishMotion() {
  if(!motionPending)return;
  const uint64_t now=esp_timer_get_time();const auto imu=imuAcquisition.snapshot();
  if(!LaunchMotion::captureReady(now,motionEnd,imu.fusedUs))return;
  // A failed ring copy (allocation or a busy ring gate) is transient: retry
  // while the samples are still buffered instead of losing the replay.
  if(!imuAcquisition.capture(motionStart,motionEnd,latestMotion.rpm,latestMotion.number,latestMotion) &&
     now<motionEnd+MOTION_CAPTURE_RETRY_US){++motionCaptureRetries;return;}
  motionPending=false;dirty=true;
  const auto state=acquisition.snapshot();
  if(state.phase==AnalogTachometer::Phase::Launch || !launchFeedback.shown() || tournamentMode || historyPage || diagnostics || motionDemo)bestEffect.clear();
  else bestEffect.captured(latestMotion.number);
  // The replay starts over now its trace is in, as it was opened.
  if(launchFeedback.shown())launchFeedback.show(millis(),launchFeedback.replay(),MotionReplay::playbackDurationMs(latestMotion));
  Serial.printf("MAIN_FEEDBACK shown=%d reason=result t_ms=%lu\n",launchFeedback.shown(),(unsigned long)millis());
  Serial.printf("MOTION_RESULT launch=%lu quality=%s points=%u duration_ms=%lu rpm=%.1f stationary_bias=%d saturated=%d bridged=%d capture_retries=%lu peak_accel_g=%.2f accel_range_g=%.0f peak_gyro_dps=%.0f gyro_range_dps=%.0f\n",
    (unsigned long)latestMotion.number,LaunchMotion::name(latestMotion.quality),latestMotion.count,
    (unsigned long)latestMotion.durationMs,latestMotion.rpm,latestMotion.stationaryBias,latestMotion.saturated,latestMotion.bridged,(unsigned long)motionCaptureRetries,
    latestMotion.peakAccelG,accelRange().fullScaleG(),latestMotion.peakGyroDps,StickS3AccelRange::GYRO_FULL_SCALE_DPS);
  if(latestMotion.issueMs!=LaunchMotion::Trace::NO_ISSUE)
    Serial.printf("MOTION_ISSUE launch=%lu quality=%s at_ms=%ld pull_ms=%lu\n",(unsigned long)latestMotion.number,
      LaunchMotion::name(latestMotion.quality),(long)latestMotion.issueMs,(unsigned long)((motionEnd-motionStart)/1000));
  Serial.printf("MOTION_TIMING launch=%lu ready_after_end_ms=%lu pre_ms=%d post_ms=%d\n",
    (unsigned long)latestMotion.number,(unsigned long)((now-motionEnd)/1000),
    latestMotion.count?-int(latestMotion.points[0].ms):0,
    latestMotion.count?int(latestMotion.points[latestMotion.count-1].ms)-int(latestMotion.durationMs):0);
  Serial.printf("RECAP_LEVEL launch=%lu start_valid=%d start_xy=%.4f,%.4f end_valid=%d end_xy=%.4f,%.4f\n",
    (unsigned long)latestMotion.number,latestMotion.startLevel.valid(),latestMotion.startLevel.right,latestMotion.startLevel.down,
    latestMotion.endLevel.valid(),latestMotion.endLevel.right,latestMotion.endLevel.down);
}
LOOP_HELPER static void exportMotion() {
  Serial.printf("RPM_CURVE_EXPORT launch=%lu count=%u stride=%u\n",(unsigned long)latestMotion.number,unsigned(latestCurve.count),unsigned(latestCurve.stride));
  for(unsigned i=0;i<latestCurve.count;++i)Serial.printf("RPM_CURVE_POINT t_ms=%u rpm=%u\n",unsigned(latestCurve.ms[i]),unsigned(latestCurve.rpm[i]));
  for(const auto *t:{&referenceMotion,&latestMotion}) {
    const char *role=t==&referenceMotion?"reference":"latest";
    Serial.printf("MOTION_EXPORT role=%s number=%lu rpm=%.3f quality=%s count=%u duration_ms=%lu stationary_bias=%d fused=%d\n",role,
      (unsigned long)t->number,t->rpm,LaunchMotion::name(t->quality),t->count,(unsigned long)t->durationMs,t->stationaryBias,t->fused);
    if(t->valid())for(unsigned i=0;i<t->count;++i) {
      const auto &p=t->points[i];Serial.printf("MOTION_POINT role=%s t_ms=%d accel_change_g=%.3f,%.3f,%.3f gyro_dps=%.1f,%.1f,%.1f q=%.5f,%.5f,%.5f,%.5f\n",
        role,p.ms,p.a[0]*.001f,p.a[1]*.001f,p.a[2]*.001f,p.g[0]*.1f,p.g[1]*.1f,p.g[2]*.1f,
        p.q[0]/16384.0f,p.q[1]/16384.0f,p.q[2]/16384.0f,p.q[3]/16384.0f);
    }
    auto replay=std::unique_ptr<MotionReplay::Replay>(new(std::nothrow) MotionReplay::Replay);
    if(replay && replay->build(*t)) {
      Serial.printf("REPLAY_EXPORT role=%s number=%lu mode=rotation_only position=disabled absolute_heading=disabled count=%u\n",
        role,(unsigned long)t->number,MotionReplay::Replay::COUNT);
      for(unsigned i=0;i<MotionReplay::Replay::COUNT;++i) {
        const auto &q=replay->pose[i];Serial.printf("REPLAY_POINT role=%s t_ms=%d gravity_aligned_q=%.5f,%.5f,%.5f,%.5f\n",role,
          replay->ms[i],q.w,q.x,q.y,q.z);
      }
    }
  }
}
LOOP_HELPER static void newSession() {
  bestEffect.clear();
  practice.newSession();newSessionAt=millis();demo=false;diagnostics=false;historyPage=false;dirty=true;
  Serial.println("HISTORY_SESSION next accepted launch starts a new session");
}
LOOP_HELPER static void previewSetting() {
  const auto s=acquisition.snapshot();
  if(s.phase==AnalogTachometer::Phase::Launch){restorePreview=true;return;}
  if(restorePreview) {
    M5.Display.setBrightness(backlightValue());M5.Display.setRotation(DisplayOrientation::rotation(displayFlipped));
    restorePreview=false;
  }
  if(controls.page==Controls::Page::Edit) {
    if(controls.setting==2)M5.Display.setBrightness((unsigned(controls.draft)*255+50)/100);
    if(controls.setting==3)M5.Display.setRotation(DisplayOrientation::rotation(bool(controls.draft)));
  }
}
// Random's upcoming pick stays available until a celebration is presented.
LOOP_HELPER static Appearance::Effect upcoming() {
  if(!Appearance::celebrates(unsigned(upcomingEffect)))upcomingEffect=EffectSet::pick(esp_random(),Appearance::Effect::Off,effectSet.mask());
  return upcomingEffect;
}
LOOP_HELPER static const Appearance::Effect *milestonePicks() {
  if(!milestonePicksReady || !milestonePicked.same(milestones)) {
    for(unsigned i=0;i<milestones.count();++i)milestoneNext[i]=Milestones::pick(Milestones::playable(milestones.row(i).pool),esp_random(),Appearance::Effect::Off);
    milestonePicked=milestones;milestonePicksReady=true;
  }
  return milestoneNext;
}
LOOP_HELPER static void nextMilestonePick(uint16_t rpm,Appearance::Effect played) {
  milestonePicks();
  for(unsigned i=0;i<milestones.count();++i)
    if(milestones.row(i).rpm==rpm)milestoneNext[i]=Milestones::pick(Milestones::playable(milestones.row(i).pool),esp_random(),played);
}
LOOP_HELPER static Appearance::Effect celebrationEffect() {
  // A loaded Best effect that cannot play here (deleted, damaged) plays its fallback.
  if(appearance.effect!=Appearance::Effect::Random)return Appearance::resolve(appearance.effect);
  return upcoming();
}
// Keep a queued recap's clip intact until its first presented frame takes the
// sound cue, including USB previews of an effect other than the saved one.
LOOP_HELPER static Appearance::Effect soundTarget(){
  if(bestEffect.badge() && !bestEffect.started())return bestEffect.effect();
  if(editorEffect.badge() && !editorEffect.started())return editorEffect.effect();
  return appearance.effect==Appearance::Effect::Random?upcoming():appearance.effect;
}
// Plays now if the sound is rendered, otherwise once the idle slices finish it.
LOOP_HELPER static void requestSound(Appearance::Effect effect,Appearance::Sound level,bool celebration) {
  soundRequest={};
  if(soundPlayer.muted)return;
  if(level==Appearance::Sound::Off){soundPlayer.stop();celebrationSound=soundPreview=false;return;}
  soundRequest.active=true;soundRequest.celebration=celebration;soundRequest.effect=effect;soundRequest.level=level;
  if(soundPlayer.prepared(effect))startSound(false);
}
// Starts the requested sound in step with its effect (SoundSync). At the
// effect's cue the effect's clock moves to where the sound will be heard; a
// sound ready only later (`late`) starts at the sample matching the frame
// then on the glass.
LOOP_HELPER static void startSound(bool late) {
  auto &shown=soundRequest.celebration?bestEffect:editorEffect;
  const bool synced=shown.started() && shown.effect()==soundRequest.effect;
  size_t skip=0;
  if(late && synced && soundPlayer.power())
    skip=SoundSync::skipSamples(millis(),soundPlayer.nextOutputUs(),presentLagUs,shown.startedAt(),BestEffectSound::RATE);
  const bool started=soundPlayer.play(soundRequest.effect,soundRequest.level,skip);
  if(started){soundSkipped=uint32_t(skip);soundShiftMs=0;songCue=nullptr;}
  if(started && synced && !late && soundPlayer.song(soundRequest.effect)) {
    songCue=&shown;songCueFrom=shown.startedAt();shown.align(millis()+SONG_HOLD_MS);
  } else if(started && synced && !late) {
    const uint32_t at=SoundSync::clockStart(millis(),soundPlayer.outputUs(),presentLagUs);
    soundShiftMs=int32_t(at-shown.startedAt());shown.align(at);
  }
  (soundRequest.celebration?celebrationSound:soundPreview)=started;soundRequest.active=false;
}
// Each B in the Sound editor plays the current effect at the draft level.
LOOP_HELPER static void previewSound(){requestSound(soundTarget(),Appearance::Sound(controls.draft),false);}
// Each B in the Best effect editor, and opening it, plays the draft around the
// value card (with its sound when Sound is on); Random shows a random pick.
LOOP_HELPER static void previewEffect() {
  static Appearance::Effect lastShown=Appearance::Effect::Off;
  const auto choice=Appearance::Effect(controls.draft);
  // A new preview silences the last one: its first frame must not hold under
  // the old sound while its own renders.
  editorEffect.clear();dirty=true;
  if(soundPreview || soundRequest.active){soundPlayer.stop();soundPreview=false;soundRequest={};}
  if(!Appearance::celebrates(unsigned(choice)) && choice!=Appearance::Effect::Random){soundPlayer.stop();soundPreview=false;soundRequest={};return;}
  lastShown=choice==Appearance::Effect::Random?EffectSet::pick(esp_random(),lastShown,effectSet.mask()):choice;
  editorEffect.queue(true,1,lastShown);editorEffect.captured(1);
}
static void cancelSettingEdit() {
  if(controls.page==Controls::Page::Wipe)cancelWipe();
  if(controls.page==Controls::Page::Edit)controls.page=Controls::Page::Settings;
  restorePreview=true;settingsSaveError=false;previewSetting();
}
// Runs inside a checkpoint the caller holds, ordinary or shutdown: the
// detector's estimator and sensor profile can only change there, and the IMU
// frame only outside a pull or capture. A cancelled power-off then leaves the
// live state matching the records. Whatever fails stays pending.
static void writeSettings() {
  const uint16_t items=settingsSave.pending();
  if(!items)return;
  uint16_t saved=0;
  const auto live=acquisition.snapshot();
  if(items&SettingsSave::Rpm) {
    bool current=live.estimator==rpmEstimator;
    // A metric change starts a new session at the moment the detector switches.
    if(!current && acquisition.request(Action::Estimator,uint8_t(rpmEstimator))){current=true;practice.newSession();launchFeedback.clear();}
    if(current && RpmEstimatorSetting::save(prefs,rpmEstimator))saved|=SettingsSave::Rpm;
  }
  if(items&SettingsSave::Sensor) {
    bool current=live.sensorProfile==sensorProfile;
    if(!current && acquisition.request(Action::SensorProfile,uint8_t(sensorProfile))) {
      current=true;practice.newSession();launchFeedback.clear();
      // Another sensor's marks: its own reference starts empty.
      startMarks.clear(uint8_t(sensorProfile));startMarksDirty=true;saveStartMarks();
    }
    if(current && SensorProfileSetting::save(prefs,sensorProfile))saved|=SettingsSave::Sensor;
  }
  if((items&SettingsSave::Sleep) && prefs.putUChar("sleep_min",inactivity.minutes())==1)saved|=SettingsSave::Sleep;
  if((items&SettingsSave::Brightness) && prefs.putUChar(Brightness::KEY,brightnessPercent)==1)saved|=SettingsSave::Brightness;
  if((items&SettingsSave::Flip) && DisplayFlipSetting::save(prefs,displayFlipped))saved|=SettingsSave::Flip;
  if((items&SettingsSave::ShakeWake) && ShakeWakeSetting::save(prefs,shakeToWake))saved|=SettingsSave::ShakeWake;
  if((items&SettingsSave::BatteryIcon) && BatteryIconSetting::save(prefs,batteryIcon))saved|=SettingsSave::BatteryIcon;
  if((items&SettingsSave::Bluetooth) && BluetoothSetting::save(prefs,bluetoothOn))saved|=SettingsSave::Bluetooth;
  if((items&SettingsSave::Bonds) && BleLink::saveBonds(prefs))saved|=SettingsSave::Bonds;
  if((items&SettingsSave::Name) && BleLink::saveName(prefs))saved|=SettingsSave::Name;
  if(items&SettingsSave::Mount) {
    bool current=liveMount==mountMode;
    if(!current && imuAcquisition.setMount(mountMode)) {
      // Level restarts in the new frame; a recap drawn in the old one goes.
      current=true;liveMount=mountMode;level=StickS3Level{};drawnLevel={};lastLevelSampleUs=0;
      launchFeedback.clear();
    }
    if(current && MountOrientationSetting::save(prefs,mountMode))saved|=SettingsSave::Mount;
  }
  if((items&SettingsSave::Appearance) && appearanceStore.saveViewed(appearance))saved|=SettingsSave::Appearance;
  if((items&SettingsSave::Milestones) && milestoneStore.save(milestones))saved|=SettingsSave::Milestones;
  if((items&SettingsSave::Pin) && prefs.putUChar("ao_pin",live.pin)==1)saved|=SettingsSave::Pin;
  if((items&SettingsSave::ExtPower) && prefs.putBool("ext5v",extPower)==1)saved|=SettingsSave::ExtPower;
  settingsSave.wrote(saved);dirty=true;
  Serial.printf("SETTINGS_SAVE items=0x%03x saved=0x%03x\n",unsigned(items),unsigned(saved));
}
// Pending settings reach flash in the first checkpoint the optical owner
// grants: right away after Apply in the usual case, otherwise as soon as the
// signal is quiet again. Never during a pull or a motion capture.
LOOP_HELPER static void saveSettings(uint32_t now,const Snapshot &s,bool immediate=false) {
  if(!settingsSave.pending() || (!immediate && !settingsSave.due(now)) || motionPending ||
     !SettingsSave::ownerIdle(s.ready,s.suspended,s.opticalIdle,s.signalFault))return;
  // Record the attempt first: a vetoed checkpoint must not repeat the IMU
  // quiet wait on every UI tick.
  settingsSave.attempted(now);
  if(!acquisition.request(Action::IdleCheckpointBegin,s.launches)){settingsSave.refused();return;}
  writeSettings();
  if(!acquisition.request(Action::CheckpointEnd))Serial.println("SETTING_ERROR acquisition_resume");
}
// Apply takes the choice at once and queues its record for flash. It never
// waits for an idle instant: pressing A can itself jiggle the launcher across
// a mark, and that used to refuse Apply after Apply with "Try again when idle".
// Takes one setting's new value in RAM, from the editor or the phone.
static bool applySetting(unsigned setting,uint8_t value,bool &changed) {
  bool applied=true;changed=false;
  switch(Controls::Setting(setting)) {
    case Controls::Setting::Sleep:
      changed=value!=inactivity.minutes();applied=inactivity.setMinutes(value);break;
    // The estimator, sensor profile and mount switch inside the save checkpoint.
    case Controls::Setting::Rpm:
      applied=RpmEstimator::valid(value);changed=applied && RpmEstimator::Mode(value)!=rpmEstimator;
      if(changed)rpmEstimator=RpmEstimator::Mode(value);
      break;
    case Controls::Setting::Brightness:changed=value!=brightnessPercent;brightnessPercent=value;break;
    case Controls::Setting::Flip:changed=bool(value)!=displayFlipped;displayFlipped=value;break;
    case Controls::Setting::ShakeWake:changed=bool(value)!=shakeToWake;shakeToWake=value;break;
    case Controls::Setting::BatteryIcon:changed=bool(value)!=batteryIcon;batteryIcon=value;break;
    case Controls::Setting::Bluetooth:changed=bool(value)!=bluetoothOn;bluetoothOn=value;break;
    case Controls::Setting::Sensor:
      applied=StickS3SensorProfile::valid(value);changed=applied && StickS3SensorProfile::Mode(value)!=sensorProfile;
      if(changed)sensorProfile=StickS3SensorProfile::Mode(value);
      break;
    case Controls::Setting::Mount:
      applied=MountOrientation::valid(value);changed=applied && MountOrientation::Mode(value)!=mountMode;
      if(changed)mountMode=MountOrientation::Mode(value);
      break;
    case Controls::Setting::Theme:case Controls::Setting::BestEffect:case Controls::Setting::Sound: {
      // An unreadable stored look cannot be replaced; keep showing it rather
      // than a choice that would silently revert at the next boot.
      using S=Controls::Setting;const auto row=S(setting);
      auto next=appearance;
      applied=appearanceStore.ready() && (row!=S::Theme || themeLibrary.available(Appearance::Theme(value))) &&
        next.select(row==S::Theme?Appearance::Theme(value):appearance.theme,
                      row==S::BestEffect?Appearance::Effect(value):appearance.effect,
                      row==S::Sound?Appearance::Sound(value):appearance.sound);
      changed=applied && next.generation()!=appearance.generation();
      if(changed)appearance=next;
      break;
    }
    case Controls::Setting::Celebrate: {
      auto next=milestones;
      applied=milestoneStore.ready() && next.select(Milestones::Mode(value));
      changed=applied && next.generation()!=milestones.generation();
      if(changed)milestones=next;
      break;
    }
    case Controls::Setting::WipeAll:case Controls::Setting::About:applied=false;break; // Neither has an editor.
  }
  return applied;
}
static void commitSetting() {
  const uint8_t value=controls.draft;
  bool changed=false;
  const bool applied=applySetting(controls.setting,value,changed);
  settingsSaveError=!applied;
  Serial.printf("SETTING_APPLY row=%u value=%u applied=%d changed=%d\n",controls.setting,value,applied,changed);
  if(applied) {
    if(changed)settingsSave.mark(SettingsSave::item(controls.setting));
    controls.page=Controls::Page::Settings;restorePreview=true;previewSetting();
    saveSettings(millis(),acquisition.snapshot(),true);
  }
  syncNavigation();
}
// The Battle Pass profile's view of this stick (ble_battle_pass.h): what an
// app for the BEYBATTLE PASS is told. Tournament mode hides RPM, so it tells
// nothing then, like the LaunchLab profile.
namespace BattlePassFeed {
LOOP_HELPER static BattlePass::Shots shots() {
  BattlePass::Shots out;
  const unsigned kept=practice.size(),listed=std::min<unsigned>(kept,BattlePass::SHOTS);
  for(unsigned i=listed;i>0;--i)out.add(BattlePass::shootPower(practice.recent(i-1)->rpm));
  float best=0;for(float rpm:personalBests.rpm)best=std::max(best,rpm);
  for(unsigned i=0;i<kept;++i)best=std::max(best,practice.recent(i)->rpm);
  out.best=BattlePass::shootPower(best);
  const auto *last=practice.recent();
  out.total=uint16_t(std::min<uint32_t>(65535,last?last->number:0));
  return out;
}
LOOP_HELPER static void sendStatus(bool attached,const BattlePass::Shots &s) {
  uint8_t id[6]={};esp_efuse_mac_get_default(id);
  const uint32_t now=millis();
  BleLink::passSend(BattlePass::status(attached,battery.valid(now)?battery.percent:-1,s.best,s.total,id));
}
// The last 50 launches and the latest one's curve. No launch yet: nothing,
// since apps refuse an empty set.
LOOP_HELPER static void sendShots(const BattlePass::Shots &s) {
  if(!s.count)return;
  BattlePass::Packet list[8],turns[4];
  BattlePass::shots(s,list);BattlePass::curve(latestCurve.rpm,latestCurve.count,turns);
  for(const auto &packet:list)BleLink::passSend(packet);
  for(const auto &packet:turns)BleLink::passSend(packet);
}
// After a pull: a top was on the launcher and has left (this stick has no
// sensor for the top, and apps place the launch by that release), then its set.
LOOP_HELPER static void launched() {
  if(tournamentMode || !BleLink::passListening())return;
  const auto s=shots();
  BleLink::passClear();sendStatus(true,s);sendStatus(false,s);sendShots(s);
}
// What an app asked for since the last pass of the loop.
LOOP_HELPER static void tick(uint32_t now) {
  const bool status=BleLink::takePassStatus(now),all=BleLink::takePassShots();
  if((!status && !all) || tournamentMode)return;
  const auto s=shots();
  if(status)sendStatus(false,s);
  if(all)sendShots(s);
}
}
LOOP_HELPER static void logLaunchMetrics(const Snapshot &s) {
  const auto *record=practice.recent();if(!record)return;
  if(!tournamentMode)BleLink::publishLaunch(record->number,record->session,s.resultRpm);
  BattlePassFeed::launched();
  Serial.printf("LAUNCH_METRICS number=%lu session=%lu selected_estimator=%s selected_rpm=%.1f three_turn_peak_rpm=%.1f single_turn_peak_rpm=%.1f units=rpm\n",
    (unsigned long)record->number,(unsigned long)record->session,RpmEstimator::name(s.estimator),
    s.resultRpm,s.sustainedPeakRpm,s.singlePeakRpm);
}
LOOP_HELPER static MicView::Mic micPageState() {
  if(micListener.state()==MicSession::State::Refused)return micListener.why()==MicSession::Why::Memory?MicView::Mic::NoMemory:MicView::Mic::Failed;
  return micListener.warm(millis())?MicView::Mic::On:MicView::Mic::Starting;
}
// The Mic RPM page alone runs the mic. Opening it mutes the speaker, which
// powers down, and then the mic starts; leaving it, however the page changed,
// stops the mic and gives the speaker back. An owner who never opens the page
// stops at the first line.
LOOP_HELPER static void tickMicPage() {
  const bool open=controls.page==Controls::Page::MicRpm;
  if(!open && micListener.off())return;
  const uint32_t now=millis();
  const auto before=micListener.state();
  micListener.tick(open,soundPlayer.powered(),now);
  soundPlayer.muted=micListener.muted();
  if(soundPlayer.muted) {
    if(soundRequest.active || soundPlayer.playing())soundPlayer.stop();
    soundRequest={};celebrationSound=soundPreview=false;
  }
  if(micListener.state()!=before)dirty=true;
  if(open && (micListener.on() && now-micPageChecked>=MIC_PAGE_FRAME_MS)) {
    micPageChecked=now;
    if(micListener.warm(now)!=micPageWarm){micPageWarm=!micPageWarm;dirty=true;}  // "warming up" ends without a reading
  }
  if(micListener.fresh())micPageFresh=true;
  if(micPageFresh && now-lastDraw>=MIC_PAGE_FRAME_MS){micPageFresh=false;dirty=true;}
}
// Sleep and power-off wait for this, so neither meets a running mic, unless
// its stop never ends: then they go ahead after MicSession::STOP_LIMIT_MS.
LOOP_HELPER static void leaveMicPage() {
  if(controls.page==Controls::Page::MicRpm){controls.page=Controls::Page::Menu;syncNavigation();dirty=true;}
}
static void browseOlder() {
  if(tournamentMode || !historyPage)return;
  const auto &h=demo?demoPractice:practice;
  const unsigned total=PracticeUI::count(h,historyView),step=PracticeUI::window(historyView);
  historyOffset=historyOffset+step<total?historyOffset+step:0;dirty=true;
}
static void navigate(Controls::Effect effect,Controls::Page previous) {
  if(previous==Controls::Page::Wipe && controls.page!=previous)wipeConfirmation.cancel();
  if(previous!=controls.page || effect==Controls::Effect::Recap || effect==Controls::Effect::Tournament)bestEffect.clear();
  if(previous==Controls::Page::Main && controls.page!=previous)launchFeedback.clear();
  if(previous!=controls.page){diagnostics=false;motionDemo=false;demo=false;historyOffset=0;}
  switch(effect) {
    case Controls::Effect::Recap:toggleFeedback();break;
    case Controls::Effect::BeginEdit:
      settingsSaveError=false;
      controls.draft=settingValue(controls.setting);
      if(controls.setting==unsigned(Controls::Setting::BestEffect))previewEffect();
      break;
    case Controls::Effect::Preview:settingsSaveError=false;previewSetting();
      if(controls.setting==unsigned(Controls::Setting::BestEffect))previewEffect();
      if(controls.setting==unsigned(Controls::Setting::Sound))previewSound();
      break;
    case Controls::Effect::Apply:commitSetting();break;
    case Controls::Effect::CancelEdit:cancelSettingEdit();break;
    case Controls::Effect::Older:browseOlder();break;
    case Controls::Effect::NewSession:newSession();break;
    case Controls::Effect::Tournament:
      if(previous==Controls::Page::Tournament && controls.page==previous)
        tournamentView=TournamentView((unsigned(tournamentView)+1)%2);
      else if(controls.page==Controls::Page::Tournament)tournamentView=TournamentView::RecordingOnly;
      launchFeedback.clear();tournamentHintUntil=millis()+2500;
      Serial.printf("TOURNAMENT_CHANGE enabled=%d display=%s\n",controls.page==Controls::Page::Tournament,tournamentViewName());
      break;
    case Controls::Effect::BeginWipe:beginWipe();break;
    case Controls::Effect::ConfirmWipe:if(wipeConfirmation.confirm(millis()))dirty=true;break;
    case Controls::Effect::CancelWipe:cancelWipe();break;
    case Controls::Effect::ForgetPhones:BleLink::forget();settingsSave.mark(SettingsSave::Bonds);break;
    case Controls::Effect::ToggleBluetooth:bluetoothOn=!bluetoothOn;settingsSave.mark(SettingsSave::Bluetooth);dirty=true;break;
    case Controls::Effect::None:break;
  }
  syncNavigation();
}
static void buttonA(){const auto p=controls.page;const auto e=controls.tapA();navigate(e,p);}
static void buttonB(){const auto p=controls.page;const auto e=controls.tapB();navigate(e,p);}
LOOP_HELPER static void holdA(){const auto p=controls.page;const auto e=controls.holdA(launchFeedback.shown());navigate(e,p);}
LOOP_HELPER static void holdB(){const auto p=controls.page;const auto e=controls.holdB(launchFeedback.shown());navigate(e,p);}
static void beginWipe() {
  restoreRx.cancel();
  wipeFailed=false;wipeConfirmation.begin(millis());
  controls.page=Controls::Page::Wipe;controls.setting=unsigned(Controls::Setting::WipeAll);
  gestureA.consumed=gestureB.consumed=true;
  syncNavigation();
}
static void cancelWipe() {
  wipeConfirmation.cancel();
  // After an erase attempt, old RAM must never be saved back into storage.
  controls.page=wipeBlocked?Controls::Page::Wipe:Controls::Page::Settings;
  controls.setting=unsigned(Controls::Setting::WipeAll);
  gestureA.consumed=gestureB.consumed=true;
  syncNavigation();
}
LOOP_HELPER static void restartAfterWipe() {
  if(wipeRestartRequested)return;
  wipeRestartRequested=true;sleepReceipt.magic=0;
  Serial.println("WIPE_RESTART");UsbTx::drain(200);delay(150);ESP.restart();
}
LOOP_HELPER static void commitWipe(const Snapshot &s) {
  // Only pollWipe's fresh physical three-second hold calls this function.
  // An active capture or newly started optical burst cannot cross the erase.
  if(!wipeCheckpointHeld && !wipeBootRecovery) {
    if(motionPending || !acquisition.request(Action::IdleCheckpointBegin,s.launches)) {
      wipeFailed=true;wipeConfirmation.begin(millis());dirty=true;
      Serial.println("WIPE_DEFERRED wait_until_idle");return;
    }
    wipeCheckpointHeld=true;
  }
  wipeBlocked=true; // Set before the first write; retained on every failure.
  soundPlayer.stop();soundRequest={};celebrationSound=soundPreview=false;
  bestEffect.clear();editorEffect.clear();launchFeedback.clear();
  restoreRx.cancel();
  startMarks.clear(uint8_t(sensorProfile));startMarksDirty=false;  // the wipe takes its key too
  DeviceWipe::NvsStore store;
  wipeComplete=DeviceWipe::begin(store)==DeviceWipe::Result::Complete;
  wipeFailed=!wipeComplete;wipeConfirmation.cancel();dirty=true;
  Serial.println(wipeComplete?"WIPE_OK release_buttons_to_restart":"WIPE_ERROR retry_or_restart_no_normal_saves");
  // Keep the ADC checkpoint held. Success restarts on button release; a
  // partial wipe may only retry/reboot, never resume ordinary RAM saves.
}
LOOP_HELPER static void pollWipe(uint32_t now,bool buttonsFresh,const Snapshot &s) {
  if(controls.page!=Controls::Page::Wipe)return;
  const bool aDown=M5.BtnA.isPressed(),bDown=M5.BtnB.isPressed();
  if(wipeComplete) {
    if(buttonsFresh && !aDown && !bDown)restartAfterWipe();
    return;
  }
  const bool clickedA=buttonsFresh && gestureA.click(M5.BtnA.wasPressed(),M5.BtnA.wasHold(),M5.BtnA.wasClicked());
  const bool clickedB=buttonsFresh && gestureB.click(M5.BtnB.wasPressed(),M5.BtnB.wasHold(),M5.BtnB.wasClicked());
  // Launches defer screen redraws. Do not accept an unseen warning or count a
  // hold while the display is frozen; require a new press after measurement.
  const bool measuring=s.phase==AnalogTachometer::Phase::Launch;
  if(measuring)gestureA.consumed=true;
  const bool wasConfirming=wipeConfirmation.active();
  if(wipeConfirmation.tick(now,aDown,bDown,buttonsFresh && !measuring)) {commitWipe(s);return;}
  if(!wipeConfirmation.active()) {
    if(wasConfirming){cancelWipe();return;}
    if(!wipeBlocked){cancelWipe();return;}
    if(clickedA)beginWipe();
    else if(clickedB)restartAfterWipe();
    return;
  }
  if(clickedA && !measuring)buttonA();
  else if(clickedB)cancelWipe();
  if(now-lastDraw>=50)dirty=true;
}
LOOP_HELPER static bool recoverWipe() {
  DeviceWipe::NvsStore store;
  const auto state=DeviceWipe::inspect(store);
  if(state==DeviceWipe::State::Clean)return true;
  if(state==DeviceWipe::State::Pending && DeviceWipe::resume(store)==DeviceWipe::Result::Complete) {
    sleepReceipt.magic=0;Serial.println("WIPE_BOOT completed_pending_erase");return true;
  }
  // No old settings/history are loaded and no acquisition task is started.
  // An invalid marker is not permission to erase; the physical flow must run.
  wipeBlocked=wipeBootRecovery=wipeFailed=true;
  controls.page=Controls::Page::Wipe;controls.setting=unsigned(Controls::Setting::WipeAll);
  M5.Display.setRotation(DisplayOrientation::rotation(false));M5.Display.setBrightness(102);M5.Display.setTextSize(1);
  M5.BtnA.setHoldThresh(1000);M5.BtnB.setHoldThresh(1000);
  syncNavigation();Serial.println("WIPE_BOOT_ERROR normal_load_and_saves_blocked");return false;
}
LOOP_HELPER static void previewHistory() {
  bestEffect.clear();
  demo=!demo;diagnostics=false;historyPage=demo;historyView=PracticeUI::View::Recent;historyOffset=0;
  if(demo && !demoPractice.size()) {
    uint32_t count=0;
    for(unsigned session=0;session<18;++session) {
      demoPractice.newSession();
      for(unsigned i=0;i<12;++i) {
        const float rpm=4200+session*130+float(int(i%5)-2)*260+i*35;
        demoPractice.accept(++count,true,rpm,session*900000+i*20000);
      }
    }
  }
  Serial.printf("HISTORY_DEMO enabled=%d synthetic display only; saved history unchanged\n",demo);dirty=true;
}
LOOP_HELPER static void exportHistory() {
  Serial.printf("HISTORY_EXPORT records=%u sessions=%u metric=peak_rpm order=oldest_first\n",practice.size(),practice.sessions());
  for(unsigned i=practice.size();i>0;--i) {
    const auto &r=*practice.recent(i-1);
    Serial.printf("HISTORY_LAUNCH number=%lu session=%lu rpm=%.3f session_seconds=%lu\n",
      (unsigned long)r.number,(unsigned long)r.session,r.rpm,(unsigned long)r.seconds);
  }
  for(unsigned i=practice.sessions();i>0;--i) {
    const auto &s=*practice.session(i-1);
    Serial.printf("HISTORY_SESSION number=%lu pulls=%lu average_rpm=%.3f best_rpm=%.3f seconds=%lu\n",
      (unsigned long)s.number,(unsigned long)s.count,s.mean(),s.best,(unsigned long)s.seconds);
  }
}
// History and bests newer than their saved copy: the log's when it is open, else NVS's.
static bool historyUnsaved(){return historyLog.isOpen()?practice.generation()!=loggedHistory:practiceStore.pending(practice);}
static bool bestsUnsaved(){return historyLog.isOpen()?personalBests.generation()!=loggedBests:bestStore.pending(personalBests);}
static bool logHistory() {
#if LAUNCHLAB_HIL
  if(Hil::nvsWrite("history",PracticeHistory::IMAGE_BYTES))return false;
#endif
  if(!historyLog.saveHistory(practice,practiceStore.savedGeneration()))return false;
  loggedHistory=practice.generation();return true;
}
static bool logBests() {
#if LAUNCHLAB_HIL
  if(Hil::nvsWrite("best",32))return false;
#endif
  if(!historyLog.saveBests(personalBests,bestStore.savedGeneration()))return false;
  loggedBests=personalBests.generation();return true;
}
// At boot, before sampling starts: the first boot of 0.18 formats the
// partition (blank, erased or another firmware's bytes) in under a second.
static void openHistoryLog() {
  if(!spiffsFlash.begin()){Serial.println("HISTORY_LOG_BOOT state=no_partition");return;}
  const int64_t started=esp_timer_get_time();
  using Open=HistoryLog::Store<SpiffsFlash>::Log::Open;
  const auto opened=historyLog.open(spiffsFlash);
  Serial.printf("HISTORY_LOG_BOOT state=%s ready_sectors=%u us=%lld\n",opened==Open::Ready?"ready":opened==Open::Formatted?"formatted":
    opened==Open::Unsupported?"unsupported_layout":"failed",historyLog.isOpen()?historyLog.log().readyCount():0u,
    (long long)(esp_timer_get_time()-started));
}
// A loaded effect's own sound, for the speaker: rendered by the store's
// engine from its own copy of the file.
struct LoadedSoundSource:BestEffectSpeaker::LoadedSounds {
  bool sound(unsigned effect,uint32_t &key,size_t &samples) override{return loadedEffects && loadedEffects->soundOf(effect,key,samples);}
  bool begin(unsigned effect) override{return loadedEffects && loadedEffects->beginSound(effect);}
  size_t run(int16_t *out,size_t count) override{return loadedEffects?loadedEffects->renderSound(out,count):0;}
  bool song(unsigned effect) override{return loadedEffects && loadedEffects->songOf(effect);}
  bool readSong(unsigned effect,const uint8_t *&file,size_t &bytes) override{return loadedEffects && loadedEffects->readSong(effect,file,bytes);}
};
static LoadedSoundSource loadedSounds;
// Songs (engine level 2) stream from a task on core 0 at priority 1, below
// the optical ADC owner and the IMU, so it renders only in core 0's idle
// time; it sleeps until a song starts. Its file copy, renderer and ring
// are in PSRAM.
static Music *music=nullptr;
static constexpr uint32_t MUSIC_STACK=3584;
static void musicTask(void *) {
  // A block a step, then the sleep step() asks for (at least 1 ms, keeping
  // the task under Music::DUTY_PERCENT of core 0); with nothing to render it
  // waits for play() to wake it.
  for(;;) {
    const uint32_t ms=music->step([]{return uint32_t(esp_timer_get_time());});
    if(ms)vTaskDelay(pdMS_TO_TICKS(ms));
    else ulTaskNotifyTake(pdTRUE,pdMS_TO_TICKS(250));
  }
}
LOOP_HELPER static void startMusic() {
  void *space=heap_caps_malloc(sizeof(Music::Space),MALLOC_CAP_SPIRAM|MALLOC_CAP_8BIT);
  void *memory=heap_caps_malloc(sizeof(Music),MALLOC_CAP_INTERNAL|MALLOC_CAP_8BIT);
  TaskHandle_t task=nullptr;
  if(space && memory) {
    music=new(memory) Music(new(space) Music::Space());
    // Internal RAM: 2,016 bytes at its deepest over the three example songs
    // (every voice type; HIL songs run, 2026-10-23), plus a 1.5 KB margin.
    if(xTaskCreatePinnedToCore(musicTask,"music",MUSIC_STACK,nullptr,1,&task,0)==pdPASS){soundPlayer.attachMusic(music,task);return;}
  }
  heap_caps_free(space);heap_caps_free(memory);music=nullptr;
  Serial.println("MUSIC_BOOT state=no_memory");
}
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
void loop() {
  CpuPower::Guard clock(CpuPower::Ui);
  bool buttonsFresh=false;
  if(imuAcquisition.lock()){M5.update();imuAcquisition.unlock();buttonsFresh=true;}
  Snapshot s=acquisition.snapshot();
  BleLink::handler=BleCommands::run;controls.bluetoothOn=bluetoothOn;
  BleLink::setPromptBusy(s.phase==AnalogTachometer::Phase::Launch || motionPending || tournamentMode || wipeBlocked ||
    controls.page==Controls::Page::Edit || controls.page==Controls::Page::Wipe);
  if(BleLink::tick(millis(),bluetoothAtBoot,s.phase==AnalogTachometer::Phase::Launch))dirty=true;
  if(BleLink::takeBondsChanged()){settingsSave.mark(SettingsSave::Bonds);dirty=true;}
  BattlePassFeed::tick(millis());
  BleCommands::tickLiveOrientation(millis(),s);
  restartForBluetooth(millis(),s);
  if(buttonsFresh && heldButtons.use(millis(),M5.BtnA.isPressed() || M5.BtnB.isPressed(),M5.BtnA.wasReleased() || M5.BtnB.wasReleased()))
    inactivity.touch(millis());
#if LAUNCHLAB_HIL
  // Nothing presses the rig's buttons: every physical edge is worth a line
  // (a Wear check reset with no USB key behind it, 2026-10-27).
  if(buttonsFresh && (M5.BtnA.wasPressed() || M5.BtnA.wasReleased() || M5.BtnB.wasPressed() || M5.BtnB.wasReleased()))
    Serial.printf("HIL_BUTTON a=%d b=%d a_pressed=%d a_released=%d b_pressed=%d b_released=%d ms=%lu\n",
      M5.BtnA.isPressed(),M5.BtnB.isPressed(),M5.BtnA.wasPressed(),M5.BtnA.wasReleased(),
      M5.BtnB.wasPressed(),M5.BtnB.wasReleased(),(unsigned long)millis());
#endif
  if(wipeBlocked) {
    pollWipe(millis(),buttonsFresh,s);
    tickDisplayPower(millis(),s);
    if(dirty){draw(s);lastDraw=millis();dirty=false;}
    clock.release();delay(IdlePowerPolicy::UI_POLL_MS);return;
  }
  pollLevel(millis());
  if(controls.page==Controls::Page::WearCheck) {
    const auto rawTilt=level.reading(millis());
    controls.wear.observeLevel(rawTilt,s.phase==AnalogTachometer::Phase::Launch);
    observeWearMount(rawTilt);
    const auto stepBefore=controls.wear.step();
    const auto stageBefore=controls.wear.stage();
    const auto unmeasured=controls.wear.observeOptics(s.detectorUs,s.strongTurns,wearDetectorReady(s),
      s.ready && !s.suspended && !s.signalFault && s.phase!=AnalogTachometer::Phase::Settling && s.phase!=AnalogTachometer::Phase::Paused);
    if(unmeasured!=WearCheck::Outcome::None)logWearPull(stageBefore,unmeasured,0.0f);
    if(controls.wear.step()!=stepBefore) {
      inactivity.touch(millis());dirty=true;
      Serial.printf("WEAR_CHECK_STEP step=%s t_us=%llu\n",WearCheck::stepName(controls.wear.step()),(unsigned long long)s.detectorUs);
    }
    if(!controls.wear.complete() && uint32_t(millis()-lastDraw)>=100) {
      const auto tilt=StickS3Level::forDisplay(rawTilt,visibleDisplayFlipped());
      if(tilt.state!=drawnLevel.state || (tilt.valid() &&
        (std::fabs(tilt.degrees-drawnLevel.degrees)>=0.15f ||
         std::fabs(tilt.right-drawnLevel.right)>=0.02f ||
         std::fabs(tilt.down-drawnLevel.down)>=0.02f)))dirty=true;
    }
  }
#if LAUNCHLAB_MOTION_ADC_GATE
  tickSensorIdle(millis(),s);
#endif
  if(controls.page==Controls::Page::Wipe)pollWipe(millis(),buttonsFresh,s);
  else if(BleCommands::answerPairing(buttonsFresh,s)){}
  else if(buttonsFresh) {
    const bool clickedA=gestureA.click(M5.BtnA.wasPressed(),M5.BtnA.wasHold(),M5.BtnA.wasClicked());
    const bool clickedB=gestureB.click(M5.BtnB.wasPressed(),M5.BtnB.wasHold(),M5.BtnB.wasClicked());
    if(M5.BtnA.wasHold())holdA();else if(clickedA){noteWearTap("button");buttonA();}
    if(M5.BtnB.wasHold())holdB();else if(clickedB)buttonB();
    wakeDisplayOnPress(M5.BtnA.wasPressed() || M5.BtnB.wasPressed());
  }
  if(wipeBlocked)return;
  pollCommands(s);
  tickMicPage();
  pollPowerKey(millis());
  Snapshot event;
  while(acquisition.takeEvent(event)) {
    if(event.revision!=lastRevision) {
      lastRevision=event.revision;
      Serial.printf("LAUNCH_RESULT valid=%d peak_rpm=%.1f revs=%lu amplitude=%.1f start_noise=%.1f launches=%lu end=%s t_us=%llu\n",
        event.valid,event.resultRpm,(unsigned long)event.revolutions,event.amplitude,event.startNoise,
        (unsigned long)event.launches,event.endName(),(unsigned long long)event.detectorUs);
      micListener.launch(event.launches,event.valid,event.resultRpm,event.burstStartHostUs,event.burstEndHostUs);
      if(controls.page==Controls::Page::WearCheck) {
        const auto stageBefore=controls.wear.stage();
        const auto stepBefore=controls.wear.step();
        const auto outcome=controls.wear.observeBurst(event.launches,event.valid,event.resultRpm,level.reading(millis()));
        if(outcome!=WearCheck::Outcome::None) {
          logWearPull(stageBefore,outcome,event.resultRpm);
          if(controls.wear.step()!=stepBefore)
            Serial.printf("WEAR_CHECK_STEP step=%s t_us=%llu\n",WearCheck::stepName(controls.wear.step()),(unsigned long long)event.detectorUs);
          if(outcome==WearCheck::Outcome::Completed) {
            Serial.printf("WEAR_CHECK_RESULT rpm=%.1f median_rpm=%.1f level_rpm=%.1f pull_down_rpm=%.1f pull_up_rpm=%.1f pulls=%u tolerance_deg=%.0f baseline_rpm=%.1f\n",
              controls.wear.overallMean(),controls.wear.overallMedianMean(),
              controls.wear.stageMean(0),controls.wear.stageMean(1),controls.wear.stageMean(2),
              controls.wear.totalAccepted(),WearCheck::TOLERANCE_DEG,WearCheck::FRESH_BASELINE_RPM);
          }
        }
      } else if(practice.accept(event.launches,event.valid,event.resultRpm,millis())) {
        prepareMotion(event);logLaunchMetrics(event);noteStartMark(event);
        inactivity.touch(millis());
        Serial.printf("HISTORY_ADDED number=%lu session=%lu rpm=%.1f\n",(unsigned long)practice.recent()->number,
          (unsigned long)practice.recent()->session,practice.recent()->rpm);
      }
      dirty=true;
    }
    if(event.phase!=lastPhase || event.signalFault!=lastFault) {
      lastPhase=event.phase;lastFault=event.signalFault;dirty=true;
      Serial.printf("RPM_STATE state=%s t_us=%llu contrast=%.1f noise=%.1f\n",event.stateName(),
        (unsigned long long)event.detectorUs,event.contrast,event.noise);
    }
  }
  s=acquisition.snapshot();
  const uint32_t now=millis();
  if(s.phase==AnalogTachometer::Phase::Launch || motionDemo || tournamentMode || historyPage || diagnostics){
    if(bestEffect.badge()){bestEffect.clear();dirty=true;}else bestEffect.clear();
  }
  // A celebration runs about as long as the recap (5 s) and starts with its
  // first frame: the recap stays until the effect has ended and the readout
  // has shown clean for CELEBRATION_HOLD_MS.
  const bool celebrationHolds=bestEffect.badge() && bestEffect.started() &&
    bestEffect.elapsed(now)<Appearance::duration(bestEffect.effect())+CELEBRATION_HOLD_MS;
  if(!celebrationHolds && launchFeedback.tick(now)){dirty=true;motionDemo=false;Serial.printf("MAIN_FEEDBACK shown=0 reason=timeout t_ms=%lu\n",(unsigned long)now);}
  if(!launchFeedback.shown())bestEffect.clear();
  // A pull being measured is use; marks that go on far longer are not.
  if(opticalGuard.measuring(now,s.phase==AnalogTachometer::Phase::Launch))inactivity.touch(now);
  finishMotion();
  retryMotion(now,s);
  saveHistory(now,s);s=acquisition.snapshot();
  saveSettings(now,s);s=acquisition.snapshot();
  releaseOrphanCheckpoint(now,s);
  pollBattery(now,s);
  tickPowerLog(now,s);
  tickHistoryLog(now,s);
  pollUsbAwake(now,s);
  tickSound(s);
#if LAUNCHLAB_MOTION_ADC_GATE
  tickSensorIdle(millis(),s);
#endif
  if(restorePreview)previewSetting();
  powerKeyOff(now,s);
  autoPowerOff(now,s);
  tickDisplayPower(millis(),acquisition.snapshot());
  tickDarkDisplay(now);
  if(newSessionAt && now-newSessionAt>=1500){newSessionAt=0;dirty=true;}
  if(stress && now-lastDraw>=50)dirty=true;
  if((M5.BtnA.isPressed() || M5.BtnB.isPressed()) && now-lastDraw>=50)dirty=true;
  if(tournamentHintUntil && int32_t(now-tournamentHintUntil)>=0){tournamentHintUntil=0;dirty=true;}
  if(diagnostics && now-lastDraw>=500)dirty=true;
  if(historyPage && historyView==PracticeUI::View::Battery && now-lastDraw>=1000)dirty=true;
  const bool effectMoving=bestEffect.moving(now) || editorEffect.moving(now);
  if((effectMoving || effectWasMoving) && now-lastDraw>=50)dirty=true;
  // One final clean frame removes the decoration; the NEW BEST label stays.
  if(dirty && (stress || s.phase!=AnalogTachometer::Phase::Launch))effectWasMoving=effectMoving;
  if(!tournamentMode && !diagnostics && !historyPage && launchFeedback.shown() && !motionPending &&
     MotionReplay::playbackNeedsFrame(motionDemo?demoMotion:latestMotion,
       launchFeedback.position(launchFeedback.replayElapsed(now)),launchFeedback.position(launchFeedback.lastReplayElapsed())) && now-lastDraw>=50)dirty=true;
  if(!tournamentMode && !diagnostics && !historyPage && !launchFeedback.shown() && now-lastDraw>=100) {
    const auto tilt=StickS3Level::forDisplay(level.reading(now),visibleDisplayFlipped());
    if(tilt.state!=drawnLevel.state || (tilt.valid() &&
      (std::fabs(tilt.degrees-drawnLevel.degrees)>=0.15f ||
       std::fabs(tilt.right-drawnLevel.right)>=0.02f || std::fabs(tilt.down-drawnLevel.down)>=0.02f)))dirty=true;
  }
#if LAUNCHLAB_POWER_LAB
  labTick(now);
  // A sleeping panel draws nothing; a frame cap holds ordinary redraws back.
  const bool labDraw=!Lab::displayAsleep && (!Lab::running || !Lab::knobs.frameMs || now-lastDraw>=Lab::knobs.frameMs*10u);
#else
  constexpr bool labDraw=true;
#endif
  // Avoid electrical display changes through an ordinary measured burst.
  // Stress mode intentionally exercises the screen even during a burst.
  // A dark screen stays due for its frame, so a press shows the latest at once.
  if(dirty && labDraw && (stress || s.phase!=AnalogTachometer::Phase::Launch) && !displayDark(now)) {
    draw(s);lastDraw=millis();dirty=false;
  }
  if(Serial && now-lastStatus>=2000){lastStatus=now;status();}
  // ADC and IMU owners retain their own clocks and priorities. Avoid waking
  // this UI task 1,000 times/second merely to inspect unchanged snapshots.
  clock.release();delay(IdlePowerPolicy::UI_POLL_MS);
}
