shadohead/launchlab/firmware/LaunchLabMini/hil.h

#pragma once
// Hardware-in-the-loop command set. Test builds only (LAUNCHLAB_HIL=1); see
// firmware/tools/hil/README.md. Included once by the sketch, after its own
// state and helpers, so the commands drive the real code paths (commitSetting,
// the IMU gate) rather than copies of them.
//
// Lines start with '!' and end with a newline. Replies start with HIL_.
#include <atomic>
#include <cstdarg>
#include <cstdio>
#include <cstring>
#include <cstdlib>
#include <nvs.h>
#include <esp_cpu.h>
#include <esp_heap_caps.h>
#include "esp_freertos_hooks.h"
#include "esp_random.h"
#include "esp_system.h"
#include "hil_optical.h"
#include "hil_imu.h"
#include "usb_tx.h"
#include "hil_resync.h"

namespace Hil {
// The sketch's RX queue is the production one (USB_RX_BUFFER_BYTES): HIL never resizes it.
static constexpr size_t UPLOAD_CHUNK=USB_RX_BUFFER_BYTES/2;
inline uint32_t bootId=0;
inline uint32_t uploads=0,uploadErrors=0;
// Long reply lines and scratch, in PSRAM on first use: the internal heap is
// the DMA-capable memory the release build has, and HIL `normal` holds a HIL
// image to the same 32 KB floor after init (0.19's loaded effects left 29 KB
// with these 4 KB in internal RAM).
template<size_t N> char *scratch(){static char *p=static_cast<char *>(heap_caps_malloc(N,MALLOC_CAP_SPIRAM|MALLOC_CAP_8BIT));return p;}
// After any failed upload, input is swallowed until "!sync" or 1 s of quiet.
inline HilResync resync;
inline bool usbIdle=false; // Let the sensor-idle pause run while USB is attached.
inline std::atomic<uint32_t> gateHolds{0},gateHeldMs{0},gateActive{0};

// ---- Reply accounting. The USB TX path drops output it cannot drain within
// its 10 ms timeout (a short write) or, once it has marked the host gone,
// overwrites its ring. A host that misses a reply reads HIL_STATUS: commands
// and last say whether the command arrived; tx_short counts replies cut short.
inline uint32_t commands=0,txShort=0;
inline char lastCommand[12]="none";
inline void reply(const char *format,...) __attribute__((format(printf,1,2)));
inline void reply(const char *format,...) {
  va_list args,copy;va_start(args,format);va_copy(copy,args);
  const int length=vsnprintf(nullptr,0,format,copy);va_end(copy);
  const size_t sent=Serial.vprintf(format,args);va_end(args);
  if(length>0 && sent<size_t(length))++txShort;
}
inline void replyLine(const char *text){reply("%s\n",text);}

// ---- IDLE0 starvation probe. The task watchdog resets the chip once IDLE0
// has not run for 5 s; this keeps the longest gap between IDLE0 runs so a
// scenario can assert a margin rather than mere survival. The hook runs
// once per tick in IDLE0 and is its only writer; !idle0 reset asks it to
// restart the maximum.
inline volatile uint32_t idle0LastUs=0,idle0MaxGapUs=0;
inline std::atomic<bool> idle0Restart{false};
inline bool idle0Hook() {
  const uint32_t now=uint32_t(esp_timer_get_time());
  if(idle0Restart.exchange(false))idle0MaxGapUs=0;
  else if(idle0LastUs && now-idle0LastUs>idle0MaxGapUs)idle0MaxGapUs=now-idle0LastUs;
  idle0LastUs=now;return true;
}
// Buffers only the command loop touches, in PSRAM from their first use and
// kept: a HIL image's internal (DMA-capable) heap then stays close to
// production's, so heap checks on the rig mean what they would on a unit.
// Anything the ADC or IMU path or a flash write reads stays internal.
template<class T> T *psram(size_t count){return static_cast<T *>(heap_caps_calloc(count,sizeof(T),MALLOC_CAP_SPIRAM|MALLOC_CAP_8BIT));}
// Every task's CPU time (run-time stats clock: esp_timer us) and core, for
// measuring a core's load as the difference between two reports.
inline void tasks() {
  constexpr UBaseType_t MAX=40;static TaskStatus_t *const list=psram<TaskStatus_t>(MAX);
  if(!list){replyLine("HIL_ERR tasks memory");return;}
  uint32_t total=0;const UBaseType_t count=uxTaskGetSystemState(list,MAX,&total);
  for(UBaseType_t i=0;i<count;++i) {
#if configTASKLIST_INCLUDE_COREID
    const int core=list[i].xCoreID==tskNO_AFFINITY?-1:int(list[i].xCoreID);
#else
    const int core=-2;
#endif
    Hil::reply("HIL_TASK name=%s core=%d priority=%u run_us=%lu stack_free=%u\n",list[i].pcTaskName,core,
      unsigned(list[i].uxCurrentPriority),(unsigned long)list[i].ulRunTimeCounter,unsigned(list[i].usStackHighWaterMark));
  }
  Hil::reply("HIL_TASKS count=%u total_us=%lu now_us=%lld\n",unsigned(count),(unsigned long)total,(long long)esp_timer_get_time());
}

// ---- NVS write faults (linker --wrap of the Preferences setters).
struct NvsFaults {
  uint32_t fail=0,slow=0,slowMs=0,writes=0,failed=0,slowed=0;
  char failKey[16]={},slowKey[16]={};
  // A pull armed to start from inside the next matching write: the loop task
  // that would read a USB !pull is itself busy saving.
  bool armed=false;int32_t armDelayMs=0;char armKey[16]={};
};
inline NvsFaults nvs;
inline bool keyMatches(const char *prefix,const char *key){return !prefix[0] || (key && !strncmp(key,prefix,strlen(prefix)));}
// Returns true when this write must fail. Called on the writing task.
inline bool nvsWrite(const char *key,size_t bytes) {
  ++nvs.writes;
  if(nvs.armed && keyMatches(nvs.armKey,key)) {
    nvs.armed=false;
    const int64_t start=esp_timer_get_time()+int64_t(nvs.armDelayMs)*1000;
    pullStartUs=start;++pullCount;
    Hil::reply("HIL_PULL n=%lu start_us=%lld trigger=nvs key=%s delay_ms=%ld\n",(unsigned long)pullCount.load(),
      (long long)start,key?key:"",(long)nvs.armDelayMs);
  }
  if(nvs.slow && keyMatches(nvs.slowKey,key)) {
    --nvs.slow;++nvs.slowed;Hil::reply("HIL_FAULT nvs_slow key=%s ms=%lu\n",key?key:"",(unsigned long)nvs.slowMs);
    delay(nvs.slowMs);
  }
  if(nvs.fail && keyMatches(nvs.failKey,key)) {
    --nvs.fail;++nvs.failed;Hil::reply("HIL_FAULT nvs_fail key=%s bytes=%u\n",key?key:"",unsigned(bytes));return true;
  }
  Hil::reply("HIL_NVS key=%s bytes=%u\n",key?key:"",unsigned(bytes));
  return false;
}

inline const char *resetName(esp_reset_reason_t r) {
  switch(r) {
    case ESP_RST_POWERON:return "poweron";case ESP_RST_SW:return "software";case ESP_RST_PANIC:return "panic";
    case ESP_RST_INT_WDT:return "int_wdt";case ESP_RST_TASK_WDT:return "task_wdt";case ESP_RST_WDT:return "wdt";
    case ESP_RST_DEEPSLEEP:return "deepsleep";case ESP_RST_BROWNOUT:return "brownout";case ESP_RST_USB:return "usb";
    case ESP_RST_JTAG:return "jtag";case ESP_RST_EXT:return "external";default:return "other";
  }
}
inline uint32_t fnv(const uint8_t *p,size_t n,uint32_t h=2166136261u){for(size_t i=0;i<n;++i)h=(h^p[i])*16777619u;return h;}

// Binary upload with per-chunk acknowledgement. HWCDC drops bytes when its RX
// queue is full, so the host sends one chunk (<= USB_RX_BUFFER_BYTES/2) per ACK.
inline bool receive(uint8_t *out,size_t bytes,uint32_t expected) {
  // A partial USB packet can sit in the TX buffer until more output follows:
  // flush every line the host waits on before it may send.
  Hil::reply("HIL_UP_READY bytes=%u chunk=%u\n",unsigned(bytes),unsigned(UPLOAD_CHUNK));UsbTx::drain(100);
  size_t got=0;uint32_t hash=2166136261u;
  while(got<bytes) {
    const size_t want=std::min(UPLOAD_CHUNK,bytes-got);size_t chunk=0;
    const uint32_t started=millis();
    while(chunk<want && millis()-started<3000) {
      const int available=Serial.available();
      if(available<=0){delay(1);continue;}
      chunk+=Serial.read(out+got+chunk,std::min(size_t(available),want-chunk));
    }
    if(chunk<want) {
      resync.begin(millis());
      Hil::reply("HIL_ERR up timeout received=%u\n",unsigned(got+chunk));++uploadErrors;return false;
    }
    hash=fnv(out+got,chunk,hash);got+=chunk;
    Hil::reply("HIL_ACK %u\n",unsigned(got));UsbTx::drain(100);
  }
  if(hash!=expected) {
    resync.begin(millis());
    Hil::reply("HIL_ERR up checksum got=%lu expected=%lu\n",(unsigned long)hash,(unsigned long)expected);++uploadErrors;return false;
  }
  ++uploads;return true;
}

inline void status() {
  auto &o=optical();auto &m=imu();auto &f=m.faults;auto &c=m.counters;float a[3],g[3];m.base(a,g);
  Hil::reply("HIL_STATUS boot_id=%08lx reset=%s uptime_ms=%lu optical=%s idle=%.0f/%.1f buffer=%lu keys=%u replaced=%llu cursor=%lld resyncs=%lu pulls=%lu pull_start_us=%lld commands=%lu last=%s tx_short=%lu\n",
    (unsigned long)bootId,resetName(esp_reset_reason()),(unsigned long)millis(),Optical::name(o.mode()),o.baseline(),o.idleNoise(),
    (unsigned long)o.bufferLength(),o.keyCount(),(unsigned long long)o.replaced(),(long long)o.cursor(),(unsigned long)o.resyncs(),
    (unsigned long)pullCount.load(),(long long)pullStartUs.load(),(unsigned long)commands,lastCommand,(unsigned long)txShort);
  Hil::reply("HIL_IMU mode=%s base_g=%.3f,%.3f,%.3f base_dps=%.1f,%.1f,%.1f profile=%lu offset_ms=%ld frames=%lu activations=%lu flushes=%lu length_fails=%lu data_fails=%lu corrupts=%lu garbles=%lu overflows=%lu natural_overflows=%lu oversizes=%lu stalls=%lu skips=%lu pending_faults=%lu,%lu,%lu,%lu,%lu,%lu,%lu jitter_us=%lu sensor_jitter_us=%lu drift_ppm=%ld freeze=%lu\n",
    Imu::name(m.mode()),a[0],a[1],a[2],g[0],g[1],g[2],(unsigned long)m.profileLength(),(long)m.offsetMs(),
    (unsigned long)c.frames.load(),(unsigned long)c.activations.load(),(unsigned long)c.flushes.load(),(unsigned long)c.lengthFails.load(),
    (unsigned long)c.dataFails.load(),(unsigned long)c.corrupts.load(),(unsigned long)c.garbles.load(),(unsigned long)c.overflows.load(),
    (unsigned long)c.naturalOverflows.load(),(unsigned long)c.oversizes.load(),(unsigned long)c.stalls.load(),(unsigned long)c.skips.load(),
    (unsigned long)f.lengthFail.load(),(unsigned long)f.dataFail.load(),(unsigned long)f.corrupt.load(),(unsigned long)f.garble.load(),
    (unsigned long)f.overflow.load(),(unsigned long)f.oversize.load(),(unsigned long)f.stall.load(),
    (unsigned long)f.jitterUs.load(),(unsigned long)f.sensorJitterUs.load(),(long)f.driftPpm.load(),(unsigned long)f.freeze.load());
  Hil::reply("HIL_FAULTS nvs_writes=%lu nvs_failed=%lu nvs_slowed=%lu nvs_pending_fail=%lu nvs_pending_slow=%lu gate_holds=%lu gate_held_ms=%lu gate_active=%lu uploads=%lu upload_errors=%lu\n",
    (unsigned long)nvs.writes,(unsigned long)nvs.failed,(unsigned long)nvs.slowed,(unsigned long)nvs.fail,(unsigned long)nvs.slow,
    (unsigned long)gateHolds.load(),(unsigned long)gateHeldMs.load(),(unsigned long)gateActive.load(),(unsigned long)uploads,(unsigned long)uploadErrors);
}
}

extern "C" {
esp_err_t __real_nvs_set_blob(nvs_handle_t handle,const char *key,const void *value,size_t length);
esp_err_t __real_nvs_set_u8(nvs_handle_t handle,const char *key,uint8_t value);
esp_err_t __real_nvs_set_u32(nvs_handle_t handle,const char *key,uint32_t value);
esp_err_t __wrap_nvs_set_blob(nvs_handle_t handle,const char *key,const void *value,size_t length) {
  return Hil::nvsWrite(key,length)?ESP_ERR_NVS_NOT_ENOUGH_SPACE:__real_nvs_set_blob(handle,key,value,length);
}
esp_err_t __wrap_nvs_set_u8(nvs_handle_t handle,const char *key,uint8_t value) {
  return Hil::nvsWrite(key,1)?ESP_ERR_NVS_NOT_ENOUGH_SPACE:__real_nvs_set_u8(handle,key,value);
}
esp_err_t __wrap_nvs_set_u32(nvs_handle_t handle,const char *key,uint32_t value) {
  return Hil::nvsWrite(key,4)?ESP_ERR_NVS_NOT_ENOUGH_SPACE:__real_nvs_set_u32(handle,key,value);
}
}

#include "hil_sound_bench.h"

// Holds the shared IMU/I2C gate from another task, as a long FIFO catch-up
// read or PM1 transfer would. Exercises the checkpoint veto and FIFO overflow.
struct HilHeapBlock {uintptr_t ptr;uint32_t size;bool used;uint32_t words[8];};
struct HilHeapWalk {HilHeapBlock *blocks;unsigned count,capacity;};
static bool hilHeapBlock(walker_heap_into_t,walker_block_info_t block,void *user) {
  auto &w=*static_cast<HilHeapWalk *>(user);
  if(w.count>=w.capacity)return false;
  HilHeapBlock &b=w.blocks[w.count++];
  b.ptr=uintptr_t(block.ptr);b.size=uint32_t(block.size);b.used=block.used;
  for(unsigned i=0;i<8;++i)b.words[i]=block.used && block.size>=4*(i+1)?static_cast<const uint32_t *>(block.ptr)[i]:0;
  return true;
}
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
