shadohead/launchlab/(commit log)

2026-10-12 Publish current LaunchLab hardware kits and source downloads
2026-10-12 Correct mount ZIP instructions and update package hashes
2026-10-13 Recommend PETG for printed mounts and assembly
2026-10-14 Align linked updater guides with current release
2026-10-22 Firmware 0.18.0 source and host tests: 40 more celebration effects, Boundless redesigned, 128-bit milestone pools, the history log in spiffs with saves that ride the ADC, the NVS reserve, new defaults
2026-10-22 Release firmware 0.18.0 beta: 40 new effects, saves that never interrupt a pull, a storage reserve
    - 40 new celebration effects in eight sets of five, each with its own sound and about five seconds long; Boundless redesigned over the whole screen; 81 effects in all, and milestones can play any of them.
    - Pulls, personal bests and the battery log save to a log in the spiffs partition in a few milliseconds while the sensor keeps measuring, so a pull during a save is measured in full. NVS keeps the 0.15-0.17 records as a mirror, so a rollback keeps working.
    - A storage reserve: a new custom theme, milestone table or effect choice is refused before NVS gets so full that saving slows down.
    - New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
2026-10-22 Promote firmware 0.18.0 to stable
    The owner hand-tested 0.18.0 (81 celebration effects, milestone pools that
    reach every effect, saves that never interrupt a pull, a storage reserve,
    new defaults) against the checklist and declared it stable. latest and
    site/public/firmware/catalog.json now point at 0.18.0; 0.17.0, 0.16.0 and
    0.14.0 stay listed as betas. Its frozen release folder keeps
    published_channel beta.
    Docs name 0.18.0 as the current release, the 0.18.0 build context drops its
    beta wording, and 0.15.0's build context notes it is superseded. Tests pin
    the new current release, add a 0.15.0 to 0.18.0 upgrade and rollback test,
    and keep the synthetic 0.19.0 for the newer-beta cases.
2026-10-23 Release firmware 0.18.1 beta: milestone saves arrive whole, sound in step, IMU watchdog fix
    - Milestone saves from the website arrive: every build reads USB into an 8 KB queue (0.18.0's 256-byte queue dropped the end of each 312-character request).
    - A request the M5 refuses partway can no longer start another transfer or run a stray command.
    - Celebration sounds start in step with their animation; the speaker mixes mono.
    - A late IMU poll no longer starves the idle task into a watchdog reset.
    - Sunblade and the slowest effects step only what they draw.
    Published on the beta channel: release gate on the exact source passed (108 host suites, 1266 hardware-in-the-loop checks, effect times wit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
2026-10-27 Promote firmware 0.20.2 to stable (#31)
    The owner hand-tested 0.20.2 (Sleep after 1 minute by default, Shake to wake) against the checklist and declared it stable. latest and site/public/firmware/catalog.json now point at 0.20.2; 0.20.1, 0.20.0, 0.19.0, 0.18.1, 0.17.0, 0.16.0 and 0.14.0 stay listed as betas. Its frozen release folder keeps published_channel beta.
    Docs name 0.20.2 as the current release, the 0.20.2 build context drops its beta wording, and 0.18.0's notes that it is superseded. The sketch README is the public description again, now of 0.20.2: since 0.20.0 the release sync had copied the private development README over it. Tests pin the new current release, add a 0.18.0 to 0.20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
2026-10-28 Promote firmware 0.20.4 to stable (#34)
    The owner checked String wear check on Top and Sidecar installs and declared 0.20.4 stable; the rest of the hand-test checklist carries over from 0.20.2, unchanged since, at the owner's choice (receipt: shadohead/custom-beypass#69). latest and site/public/firmware/catalog.json now point at 0.20.4; 0.20.3, 0.20.1, 0.20.0, 0.19.0, 0.18.1, 0.17.0, 0.16.0 and 0.14.0 stay listed as betas. Its frozen release folder keeps published_channel beta.
    Docs name 0.20.4 as the current release, the 0.20.4 build context drops its beta wording, and 0.20.2's notes that it is superseded. The sketch README describes 0.20.4. Tests pin the new current release, add a 0.20.2 t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
2026-11-04 Release firmware 0.20.6 beta: the battery and sleep fixes (#37)
    * Release firmware 0.20.6 beta: the battery and sleep fixes
    The frozen private 0.20.6-sticks3-songs-pm (application 2a26b884...), gated
    on custom-beypass 86e12daf: a unit no longer stays awake until its battery is
    flat when it keeps moving after use, when NVS refuses a write, when steady
    light reaches the sensor or when a button stays pressed; standby finishes its
    power-off after an unplug from a charger, the codec and the green LED stay
    off, and the display sends only the rows that changed.
    Production source and tests synced from the gated commit (new: adc_clock.h,
    es8311_power.h, frame_rows.h, power_savers.h, the battery lab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
2026-11-06 Release firmware 0.20.8 beta: About, the battery icon and songs without gaps (#39)
2026-11-07 Promote firmware 0.20.8 to stable (#40)
    latest and the default catalog point at 0.20.8 and beta is null; 0.20.7 and
    0.20.6 stay listed as betas. Docs name 0.20.8 as the recommended release,
    the sketch README describes 0.20.6-0.20.8 and their new Menu and Settings
    rows, and the site tests pin 0.20.8, with about-upgrade.test.js covering the
    upgrade from and rollback to 0.20.5, 0.20.6 and 0.20.7.
2026-11-10 Tests and docs take the current release from the index (#41)
    * Site tests take the current release from the catalog and index
    The tests named the current stable release, its size and its SHA-256 in
    titles, regexes and literals, so every promotion edited a dozen test files.
    They now read them from site/public/firmware/catalog.json and versions.json.
    The literal stable list becomes structural checks (newest first, a catalog
    on disk for every entry, latest is the first stable and the default catalog,
    beta is nothing or newer, no release in both lists) plus a pinned table of
    every release offered on 2026-11-06 with its application SHA-256: a stable
    release stays stable, a superseded beta stays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
2026-11-12 Firmware 0.20.9 (beta): experimental Bluetooth, the Menu in groups, a charging icon (#44)
    * Sync the firmware host suite, its runner and the HIL tools from the private repository
    The firmware source is 0.20.8's, unchanged. scripts/sync_public_firmware.py
    in the private repository copied what contributors need to test a change
    here, and will keep it in step at each release:
    - the shared host suite runner (scripts/firmware_tests.py with its compile
    cache), which scripts/test-firmware.sh now runs, and every test that needs
    nothing private: the screen render check (with its renderer and an M5GFX
    fetch script), the release compatibility tests and the HIL tool tests;
    - the HIL tools, with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
2026-11-12 Firmware 0.20.10 (beta): battery savers and the charging percentage (#45)
